epccs/Gravimetric/Applications/DayNight/README.md

# Day-Night State Machine

## Overview

The manager has a day-night state machine that tracks voltage on the ALT_V power input (photovoltaic) to tell if it is day or night. The 324pb application controler can access the state machine over I2C.

Note: use the Day_AttachDayWork() and Night_AttachWork() functions to register a callback that will be run at the start of each day. This framework is how I debugged the day-night stat machine.

## Wiring Needed for Light Sensor

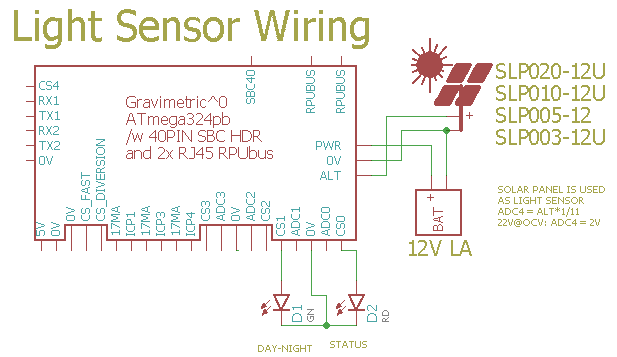
[picture p15: Applications/DayNight/Setup/LightSensorWiring.png]
Wiring


The ALT input has a [voltage divider] that is used to sense input voltage (solar pannel or a current source).

[voltage divider]: https://en.wikipedia.org/wiki/Voltage_divider

# Firmware Upload

The manager needs to be told that it has a localhost and the address to bootload. I do this with some commands on the SMBus interface from an R-Pi.

``` 
sudo apt-get install i2c-tools python3-smbus
sudo usermod -a -G i2c your_user_name
# logout for the change to take
python3
import smbus
bus = smbus.SMBus(1)
#write_i2c_block_data(I2C_ADDR, I2C_COMMAND, DATA)
#read_i2c_block_data(I2C_ADDR, I2C_COMMAND, NUM_OF_BYTES)
# what is my address
bus.write_i2c_block_data(42, 0, [255])
print("'"+chr(bus.read_i2c_block_data(42, 0, 2)[1])+"'" )
'2'
# I want to bootload address '1'
bus.write_i2c_block_data(42, 3, [ord('1')])
print("'"+chr(bus.read_i2c_block_data(42, 3, 2)[1])+"'" )
'1'
# clear the host lockout status bit so nRTS from my R-Pi on '2' will triger the bootloader on '1'
bus.write_i2c_block_data(42, 7, [0])
print(bus.read_i2c_block_data(42,7, 2))
[7, 0]
exit()
```

Or use the bootload port.

Now the serial port connection (see BOOTLOAD_PORT in Makefile) can reset the MCU and execute optiboot so that the 'make bootload' rule can upload a new binary image in the application area of flash memory.

``` 
sudo apt-get install make git picocom gcc-avr binutils-avr gdb-avr avr-libc avrdude
git clone https://github.com/epccs/Gravimetric/
cd /Gravimetric/Applications/DayNight
make
make bootload
...
avrdude done.  Thank you.
``` 

Now connect with picocom (or ilk).

``` 
#exit is C-a, C-x
picocom -b 38400 /dev/ttyAMA0
# with bootload port
picocom -b 38400 /dev/ttyUSB0
``` 

# Commands

Commands are interactive over the serial interface at 38400 baud rate. The echo will start after the second character of a new line. 

## /\[rpu_address\]/\[command \[arg\]\]

rpu_address is taken from the manager at I2C address 0x29 (e.g. ../Uart/id.h get_Rpu_address() ). The value of rpu_address is used as a character in a command string, which means don't use a null value (C strings are null terminated), but the ASCII value for '1' (0x31) is easy and looks nice.

The STATUS_LED is bliked fast (twice per second) if the I2C address is not found, also the rpu_address defaults to '0'. 

Commands and their arguments follow.

## /0/id? \[name|desc|avr-gcc\]

Identify is from ../Uart/id.h Id().

``` 
/1/id?
{"id":{"name":"DayNight","desc":"Gravimetric (17341^1) Board /w ATmega324pb","avr-gcc":"5.4.0"}}
```

## /0/dnmdebounc? [value]

Set manager daynight state machine daynight_morning_debounce.

```
/1/dnmdebounc?
{"mor_debounce":"1200000"}
/1/dnmdebounc? 18000
{"mor_debounce":"18000"}
/1/dnmdebounc?
{"mor_debounce":"18000"}
```

## /0/dnedebounc? [value]

Set manager daynight state machine daynight_evening_debounce.

```
/1/dnedebounc?
{"eve_debounce":"1200000"}
/1/dnedebounc? 18000
{"eve_debounce":"18000"}
/1/dnedebounc?
{"eve_debounce":"18000"}
```

## /0/dnmthresh? [value]

Set daynight state machine daynight_morning_threshold

```
/1/dnmthresh?
{"mor_threshold":"80"}
```

## /0/dnethresh? [value]

Set daynight state machine daynight_evening_threshold

```
/1/dnethresh?
{"eve_threshold":"40"}
```

## /0/day?

Report status of the state machine.

``` 
/1/day?
{"state":"0x0","mor_threshold":"80","eve_threshold":"40","adc_alt_v":"0","mor_debounce":"18000","eve_debounce":"18000","dn_timer":"21638728"}
{"state":"0x0","mor_threshold":"80","eve_threshold":"40","adc_alt_v":"0","mor_debounce":"18000","eve_debounce":"18000","dn_timer":"21643726"}
{"state":"0x0","mor_threshold":"80","eve_threshold":"40","adc_alt_v":"0","mor_debounce":"18000","eve_debounce":"18000","dn_timer":"21648726"}
{"state":"0x0","mor_threshold":"80","eve_threshold":"40","adc_alt_v":"0","mor_debounce":"18000","eve_debounce":"18000","dn_timer":"21653726"}
{"state":"0x0","mor_threshold":"80","eve_threshold":"40","adc_alt_v":"0","mor_debounce":"18000","eve_debounce":"18000","dn_timer":"21658725"}
{"state":"0x0","mor_threshold":"80","eve_threshold":"40","adc_alt_v":"0","mor_debounce":"18000","eve_debounce":"18000","dn_timer":"21663725"}
{"state":"0x5","mor_threshold":"80","eve_threshold":"40","adc_alt_v":"239","mor_debounce":"18000","eve_debounce":"18000","dn_timer":"2885"}
{"state":"0x5","mor_threshold":"80","eve_threshold":"40","adc_alt_v":"239","mor_debounce":"18000","eve_debounce":"18000","dn_timer":"7885"}
{"state":"0x5","mor_threshold":"80","eve_threshold":"40","adc_alt_v":"239","mor_debounce":"18000","eve_debounce":"18000","dn_timer":"12885"}
{"state":"0x5","mor_threshold":"80","eve_threshold":"40","adc_alt_v":"239","mor_debounce":"18000","eve_debounce":"18000","dn_timer":"17885"}
Day: Charge the battry
        WaterTheGarden
{"state":"0x1","mor_threshold":"80","eve_threshold":"40","adc_alt_v":"239","mor_debounce":"18000","eve_debounce":"18000","dn_timer":"4884"}
{"state":"0x1","mor_threshold":"80","eve_threshold":"40","adc_alt_v":"239","mor_debounce":"18000","eve_debounce":"18000","dn_timer":"9884"}
{"state":"0x1","mor_threshold":"80","eve_threshold":"40","adc_alt_v":"238","mor_debounce":"18000","eve_debounce":"18000","dn_timer":"14884"}
{"state":"0x2","mor_threshold":"80","eve_threshold":"40","adc_alt_v":"0","mor_debounce":"18000",Night: Block PV caused night current loss
          TurnOnLED's
"eve_debounce":"18000","dn_timer":"30"}
{"state":"0x4","mor_threshold":"80","eve_threshold":"40","adc_alt_v":"0","mor_debounce":"18000","eve_debounce":"18000","dn_timer":"5014"}
{"state":"0x4","mor_threshold":"80","eve_threshold":"40","adc_alt_v":"0","mor_debounce":"18000","eve_debounce":"18000","dn_timer":"10014"}
{"state":"0x4","mor_threshold":"80","eve_threshold":"40","adc_alt_v":"0","mor_debounce":"18000","eve_debounce":"18000","dn_timer":"15014"}
```

The state is unknown until the application receives an event update.
