epccs/Gravimetric/Manager/manager/PointToPoint.md

# Point To Point and Management Commands

16..31 (Ox10..0x1F | 0b00010000..0b00011111)

16. set arduino_mode (uint8_t)
17. read arduino_mode (uint8_t)
18. Access battery_low_limit (uint16_t)
19. Access battery_high_limit (uint16_t)
20. Battery absorption (e.g., alt_pwm_accum_charge_time) time (uint32_t)
21. morning_threshold (uint16_t). Day starts when ALT_V is above morning_threshold for morning_debouce time.
22. evening_threshold (uint16_t). Night starts when ALT_V is bellow evening_threshold for evening_debouce time.
23. Day-Night state (4 x uint8_t).

Note: morning_debouce and evening_debouce are part of the Day-Night state machine but there I2C commands are found in the test section (for now).

## Cmd 16 from a controller /w i2c-debug set p2p mode

set arduino_mode so LOCKOUT_DELAY and BOOTLOADER_ACTIVE last forever when the host RTS toggles active. Arduino IDE can then make p2p connections to the bootload address.

``` 
picocom -b 38400 /dev/ttyUSB0
/1/iaddr 41
{"address":"0x29"}
/1/ibuff 16,1
{"txBuffer[2]":[{"data":"0x10"},{"data":"0x01"}]}
/1/iread? 2
{"rxBuffer":[{"data":"0x10"},{"data":"0x01"}]}
``` 

That was silly since i2c-debug will read the RPUbus address over I2C and cause the manager to send a normal mode (e.g., point to multi-point) on the DTR pair. 

## Cmd 16 from a Raspberry Pi set p2p mode

An R-Pi host can do it with SMBus, lets try with two RPUpi boards.

``` 
python3
import smbus
bus = smbus.SMBus(1)
#write_i2c_block_data(I2C_ADDR, I2C_COMMAND, DATA)
#read_i2c_block_data(I2C_ADDR, I2C_COMMAND, NUM_OF_BYTES)
# what is the bootload address
bus.write_i2c_block_data(42, 2, [255])
bus.read_i2c_block_data(42, 2, 2)
[2, 48]
# what is my address
bus.write_i2c_block_data(42, 0, [255])
bus.read_i2c_block_data(42, 0, 2)
[0, 50]
# set the bootload address to my address
bus.write_i2c_block_data(42, 3, [ord('2')])
bus.read_i2c_block_data(42, 3, 2)
[3, 50]
# clear the host lockout status bit so serial from this host can work
bus.write_i2c_block_data(42, 7, [0])
print(bus.read_i2c_block_data(42, 7, 2))
[7, 0]
exit()
# on an RPUno load the blinkLED application which does not read the bus address
git clone https://github.com/epccs/RPUno
cd /RPUno/BlinkLED
make
make bootload
# now back to 
python3
import smbus
bus = smbus.SMBus(1)
# and set the arduino_mode
bus.write_i2c_block_data(42, 16, [1])
print(bus.read_i2c_block_data(42, 16, 2))
[16, 1]
# the R-Pi host can now connect by serial so LOCKOUT_DELAY and BOOTLOADER_ACTIVE last forever
``` 

Now the R-Pi can connect to serial in P2P mode.

``` 
picocom -b 38400 /dev/ttyAMA0
``` 

At this time, the point to point mode persists, I will sort out more details when they are needed.

## Cmd 17 from a Raspberry Pi read p2p mode

An R-Pi host can use SMBus to check for p2p mode.

```
python3
import smbus
bus = smbus.SMBus(1)
#write_i2c_block_data(I2C_ADDR, I2C_COMMAND, DATA)
#read_i2c_block_data(I2C_ADDR, I2C_COMMAND, NUM_OF_BYTES)
# is it in p2p mode (a zero shows that the running app has read the rpubus address)
bus.write_i2c_block_data(42, 17, [255])
print(bus.read_i2c_block_data(42, 17, 2))
[65, 0]
```

## Cmd 18 from a controller /w i2c-debug to access battery_low_limit

Send an ignored integer (0) in two bytes to see what the battery_low_limit value is.

``` 
# I am using the bootload interface 
picocom -b 38400 /dev/ttyUSB0
/1/iaddr 41
{"address":"0x29"}
/1/ibuff 18,0,0
{"txBuffer[3]":[{"data":"0x12"},{"data":"0x0"},{"data":"0x0"}]}
/1/iread? 3
{"rxBuffer":[{"data":"0x12"},{"data":"0x1"},{"data":"0x76"}]}
```

The settings are in battery_limits.h. The power_manager.c routines use the value to start charging, and when analogRead(PWR_V) is halfway between battery_low_limit and battery_high_limit to start modulating (PWM) the charge. To convert the value to the corrected voltage see command 35 ( (( (2**8)*0x1 + 0x76)/1024)*5.0*((100+15.8)/15.8) = 13.38V).

``` 
/1/ibuff 18,1,119
{"txBuffer[3]":[{"data":"0x12"},{"data":"0x1"},{"data":"0x77"}]}
/1/iread? 3
{"rxBuffer":[{"data":"0x12"},{"data":"0x1"},{"data":"0x76"}]}
/1/ibuff 18,0,0
{"txBuffer[3]":[{"data":"0x12"},{"data":"0x0"},{"data":"0x0"}]}
/1/iread? 3
{"rxBuffer":[{"data":"0x12"},{"data":"0x1"},{"data":"0x77"}]}
```

The data sent was swapped with the default; the second exchange has ignored data so we can see the updated value did change.

## Cmd 19 from a controller /w i2c-debug to access battery_high_limit

Send an ignored integer (0) in two bytes to see what the battery_high_limit value is.

``` 
# I am using the bootload interface 
picocom -b 38400 /dev/ttyUSB0
/1/iaddr 41
{"address":"0x29"}
/1/ibuff 19,0,0
{"txBuffer[3]":[{"data":"0x13"},{"data":"0x0"},{"data":"0x0"}]}
/1/iread? 3
{"rxBuffer":[{"data":"0x13"},{"data":"0x1"},{"data":"0x8D"}]}
```

The settings are in battery_limits.h. The power_manager.c routines use the value to stop charging, and when analogRead(PWR_V) is halfway between battery_low_limit and battery_high_limit to start modulating (PWM) the charge. To convert the value to the corrected voltage see command 35 ( (( (2**8)*0x1 + 0x8D)/1024)*5.0*((100+15.8)/15.8) = 14.21V).

``` 
/1/ibuff 19,1,142
{"txBuffer[3]":[{"data":"0x13"},{"data":"0x1"},{"data":"0x8E"}]}
/1/iread? 3
{"rxBuffer":[{"data":"0x13"},{"data":"0x1"},{"data":"0x8D"}]}
/1/ibuff 19,0,0
{"txBuffer[3]":[{"data":"0x13"},{"data":"0x0"},{"data":"0x0"}]}
/1/iread? 3
{"rxBuffer":[{"data":"0x13"},{"data":"0x1"},{"data":"0x8E"}]}
```

The data sent was swapped with the default; the second exchange has ignored data so we can see the updated value did change.

## Cmd 20 from the application controller /w i2c-debug running read alt_pwm_accum_charge_time.

Battery absorption occures durring alt_pwm_accum_charge_time, it accumulates the millis time while alternat power was used to charge the battery not the off time. Read four bytes from I2C. They are bytes to a UINT32 from a buffered accumulation of millis reading.

``` 
picocom -b 38400 /dev/ttyUSB0
/1/iaddr 41
{"address":"0x29"}
/1/ibuff 20,0,0,0,0
{"txBuffer[5]":[{"data":"0x14"},{"data":"0x0"},{"data":"0x0"},{"data":"0x0"},{"data":"0x0"}]}
/1/iread? 5
{"rxBuffer":[{"data":"0x14"},{"data":"0x0"},{"data":"0x0"},{"data":"0x0"},{"data":"0x0"}]}
``` 

This needs checked with a battery.

## Cmd 21 from a controller /w i2c-debug to access morning_threshold

Send an ignored integer (0) in two bytes to see what the morning_threshold value is.

``` 
# I am using the bootload interface 
picocom -b 38400 /dev/ttyUSB0
/1/iaddr 41
{"address":"0x29"}
/1/ibuff 21,0,0
{"txBuffer[3]":[{"data":"0x15"},{"data":"0x0"},{"data":"0x0"}]}
/1/iread? 3
{"rxBuffer":[{"data":"0x15"},{"data":"0x0"},{"data":"0x50"}]}
```

There are two ranges (12V and 24V) for solar panels; data that is outside the valid area is ignored. The settings are in daynight_limits.h. 

``` 
/1/ibuff 21,0,81
{"txBuffer[3]":[{"data":"0x15"},{"data":"0x0"},{"data":"0x51"}]}
/1/iread? 3
{"rxBuffer":[{"data":"0x15"},{"data":"0x0"},{"data":"0x50"}]}
/1/ibuff 21,0,0
{"txBuffer[3]":[{"data":"0x15"},{"data":"0x0"},{"data":"0x0"}]}
/1/iread? 3
{"rxBuffer":[{"data":"0x15"},{"data":"0x0"},{"data":"0x51"}]}
```

The data sent was swapped with the default (80); the second exchange has ignored data that is swapped with the updated value (81).

## Cmd 22 from a controller /w i2c-debug to access evening_threshold

Send an ignored integer (0) in two bytes to see what the evening_threshold value is.

``` 
# I am using the bootload interface 
picocom -b 38400 /dev/ttyUSB0
/1/iaddr 41
{"address":"0x29"}
/1/ibuff 22,0,0
{"txBuffer[3]":[{"data":"0x16"},{"data":"0x0"},{"data":"0x0"}]}
/1/iread? 3
{"rxBuffer":[{"data":"0x16"},{"data":"0x0"},{"data":"0x28"}]}
```

There are two ranges (12V and 24V) for solar panels; data that is outside the valid area is ignored. The settings are in daynight_limits.h. 

``` 
/1/ibuff 22,0,37
{"txBuffer[3]":[{"data":"0x16"},{"data":"0x0"},{"data":"0x25"}]}
/1/iread? 3
{"rxBuffer":[{"data":"0x16"},{"data":"0x0"},{"data":"0x28"}]}
/1/ibuff 22,0,0
{"txBuffer[3]":[{"data":"0x16"},{"data":"0x0"},{"data":"0x0"}]}
/1/iread? 3
{"rxBuffer":[{"data":"0x16"},{"data":"0x0"},{"data":"0x25"}]}
```

The data sent was swapped with the default (40); the second exchange has ignored data that is swapped with the updated value (37).

## Cmd 23 from a controller /w i2c-debug to set Day-Night i2c callback (4 x uint8_t).

Send four bytes to enable i2c callback for events. Address, daynight_state events, day event, night event. 

Address (0x31) is the i2c slave address that will receive the events. The daynight_state event (0x1) is the command byte used when daynight_state changes. The day (0x2) and night (0x3) event command is called so user functions can run functions.  The i2c slave needs to be implemented for the callbacks to operate, the manager will keep trying to master the i2c bus, but quit after an address NAK. 

``` 
# I am using the bootload interface 
picocom -b 38400 /dev/ttyUSB0
/1/iaddr 41
{"address":"0x29"}
/1/ibuff 23,43,1,2,3
{"txBuffer[5]":[{"data":"0x17"},{"data":"0x31"},{"data":"0x1"},{"data":"0x2"},{"data":"0x3"}]}
/1/iread? 5

```

States are in the daynight_state.h file.

``` C
#define DAYNIGHT_START_STATE 0
#define DAYNIGHT_DAY_STATE 1
#define DAYNIGHT_EVENING_DEBOUNCE_STATE 2
#define DAYNIGHT_NIGHTWORK_STATE 3
#define DAYNIGHT_NIGHT_STATE 4
#define DAYNIGHT_MORNING_DEBOUNCE_STATE 5
#define DAYNIGHT_DAYWORK_STATE 6
#define DAYNIGHT_FAIL_STATE 7
```

It is night since ALT_V was 0V after startup, it will switch to 7 after 20 hours, but if not needed don't worry about it. 

Set bit 4 from master to clear bits 6 and 7

``` 
/1/ibuff 23,16
{"txBuffer[3]":[{"data":"0x17"},{"data":"0x10"}]}
/1/iread? 2
{"rxBuffer":[{"data":"0x17"},{"data":"0x4"}]}
```

Set bit 5 from master to include bits 6 and 7 in readback

```
/1/ibuff 23,32
{"txBuffer[3]":[{"data":"0x17"},{"data":"0x20"}]}
/1/iread? 2
{"rxBuffer":[{"data":"0x17"},{"data":"0x4"}]}
```

Bit 6 shows day_work. Bit 7 shows night_work. If set they need to be cleared after doing the work.
