epccs/Gravimetric/Hardware/Schooling/Gravimetric^0,Rework_R4.jpg

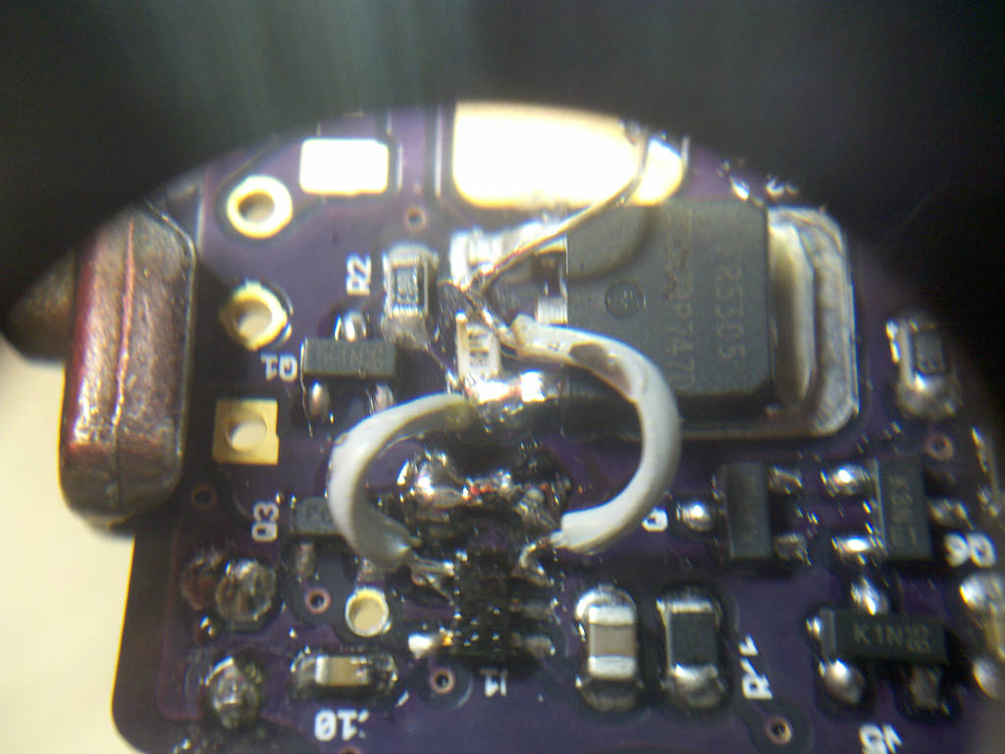
Hardware/Schooling/Gravimetric^0,Rework_R4.jpg
