epccs/Gravimetric/Hardware/Schooling/Gravimetric^1,R237_LayoutRef.png

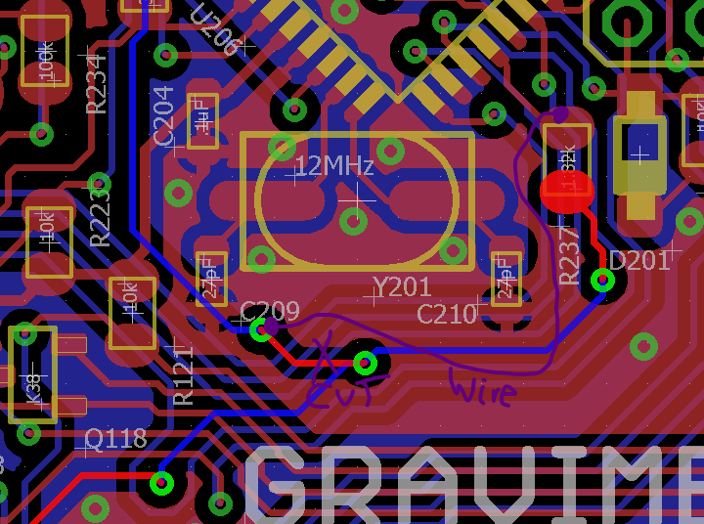
Hardware/Schooling/Gravimetric^1,R237_LayoutRef.png
