epccs/Gravimetric/Hardware/Design/17341BRD,BOM.csv

LINE | REF | QTY | EPCCS TYP | EPCCS PN | MFG@PN | DESCRIPTION | NOTES | COST EA | LINE COST | BIN
 |  |  |  |  |  | Gravimetric Board |  |  | TOTAL
 |  |  |  |  |  | 3/22/19 (17341^2) |  |  | =SUM(J5:J100)
1 |  | =1/3 | BOARD | OSHPARK |  | PCB 2 LAYER ENIG 3 COPY | () | 62.00 | =C5*I5 | GRAVIMETRIC
 |  |  |  |  |  | NOTES
