epccs/Gravimetric/Applications/Time-WeightCal/Setup/compact-prover.jpg

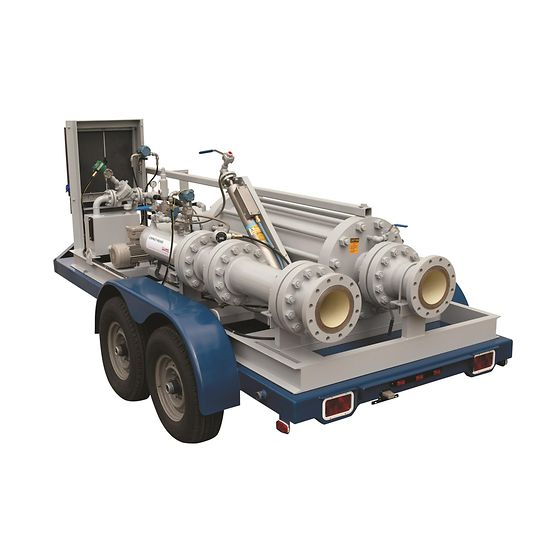
Applications/Time-WeightCal/Setup/compact-prover.jpg
