epccs/Gravimetric/Applications/Time-WeightCal/Setup/displacement_prover.jpg

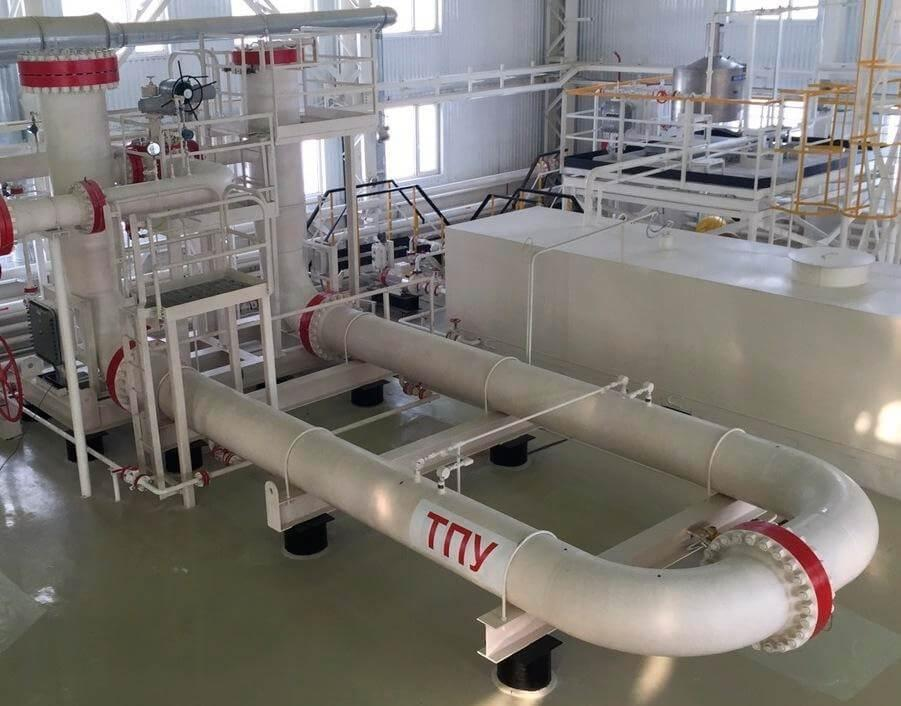
Applications/Time-WeightCal/Setup/displacement_prover.jpg
