epccs/Gravimetric/Applications/Time-WeightCal/Setup/master_meter_prover.jpg

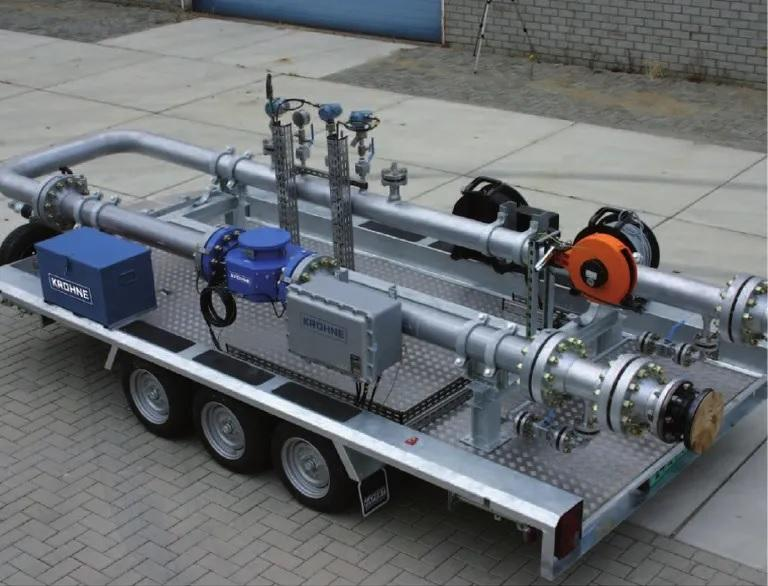
Applications/Time-WeightCal/Setup/master_meter_prover.jpg
