epccs/Gravimetric/(threads)

Thread 1 (2020-01-24):

Verify that the m32[48]pb Clock Fail Disable bit works.

epccs, 2020-01-24:
The default is 0. For a fuse, that means it is set, confusing? Yes! I have been setting it to 1 thinking... well enough about that.

My current hypothesis is that the chip will start in a failed mode (e.g., 8MHz internal) and then switch to the softly driven pendulum (low power crystal). However, once in that mode, if the crystal fails, it will be latched to the internal oscillator.

To test, I may be able to short the oscillator input pin to the ground at start-up and watch blink rate, then open the short, and see if it is faster, and short again to see if it slows and keeps going slow when open again.

epccs, 2020-01-24:
AN2365 Using CFD for ATmega328PB

http://ww1.microchip.com/downloads/en/Appnotes/AN2365-Using-CFD-for-ATmega328PB-DS00002365B.pdf

Thread 3 (2020-07-16):

I2C multi-boss bug

epccs, 2020-07-16:
Three Little Daemons

Actually, they are three state machines running. The day-night daemon (again it's a state machine) tracks the status of the alternate power input which could go to a solar panel. The battery-manager (bm) charges during the DAY and disconnects at other day-night states. The bm has some charging modes and trips the host shutdown if the battery is low. The host shutdown daemon enables the manual switch 90 seconds after powerup or after bringing the host UP from shutdown. When a shutdown occurs by software or manual switch the current is monitored to be stable for 90 seconds and then a 40-second delay occurs before removing power. The 90-second wait can be skipped if the application will stop alternating current usage (blinking LEDs) to cause current usage to be stable.

The daemons are done so that they can report state changes over I2C to the manager. This is done by changing the roles of the I2C devices, normally the application plays the role of boss, and sends things to the peon. But today the peon gets to become the new boss and send daemon events to the old demoted boss. Unfortunately, if the old boss tries to access things again the promoted peon can at times defecate on his ostentation (a bug I have not tied to fix, it seems appropriate for the times).
