epccs/Gravimetric/Hardware/Documents/17341,bAssy.pdf

5V IN | uUSB | HDMI

# uSD

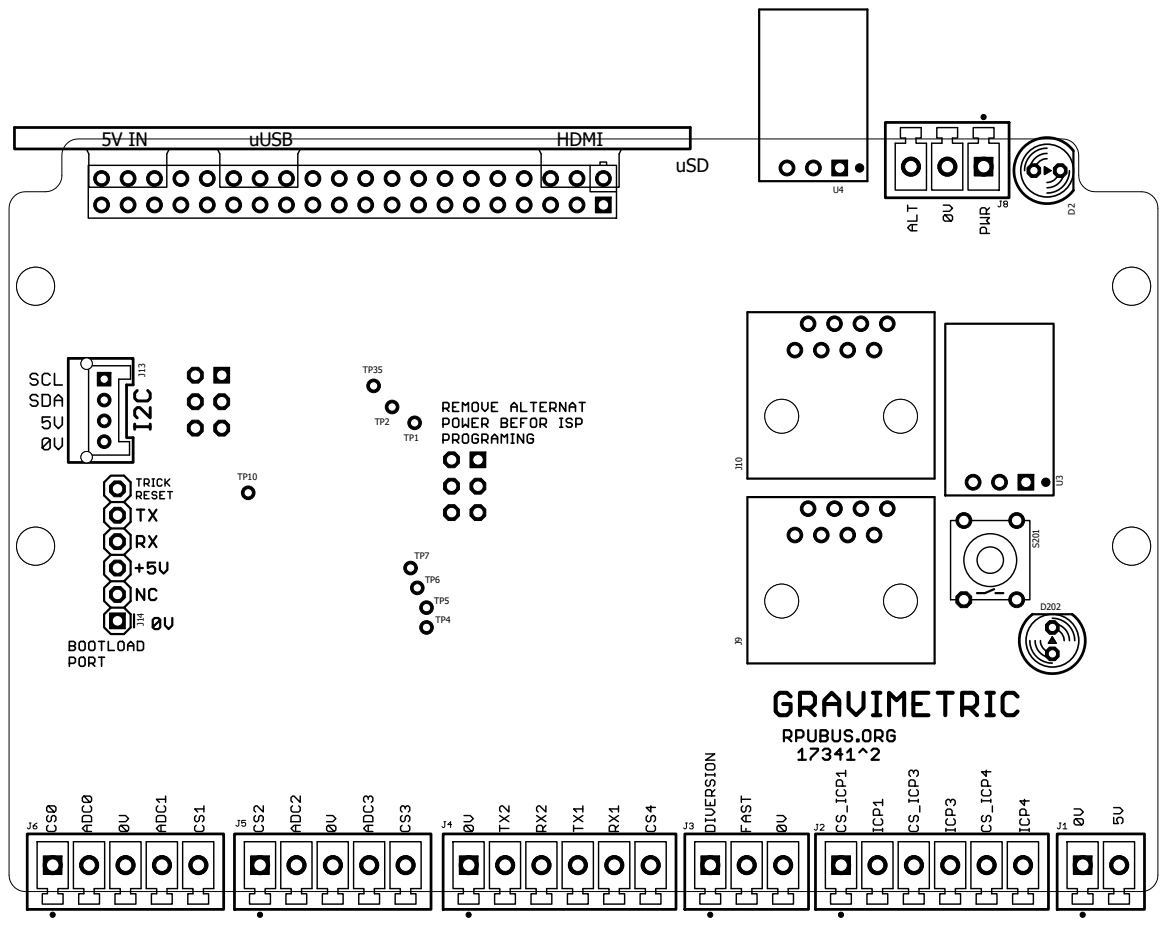
[picture p34: page 1]
