epccs/Gravimetric/Hardware/Documents/17341,Schematic.pdf

## POWER 7-36V

## BLOCKS -40V

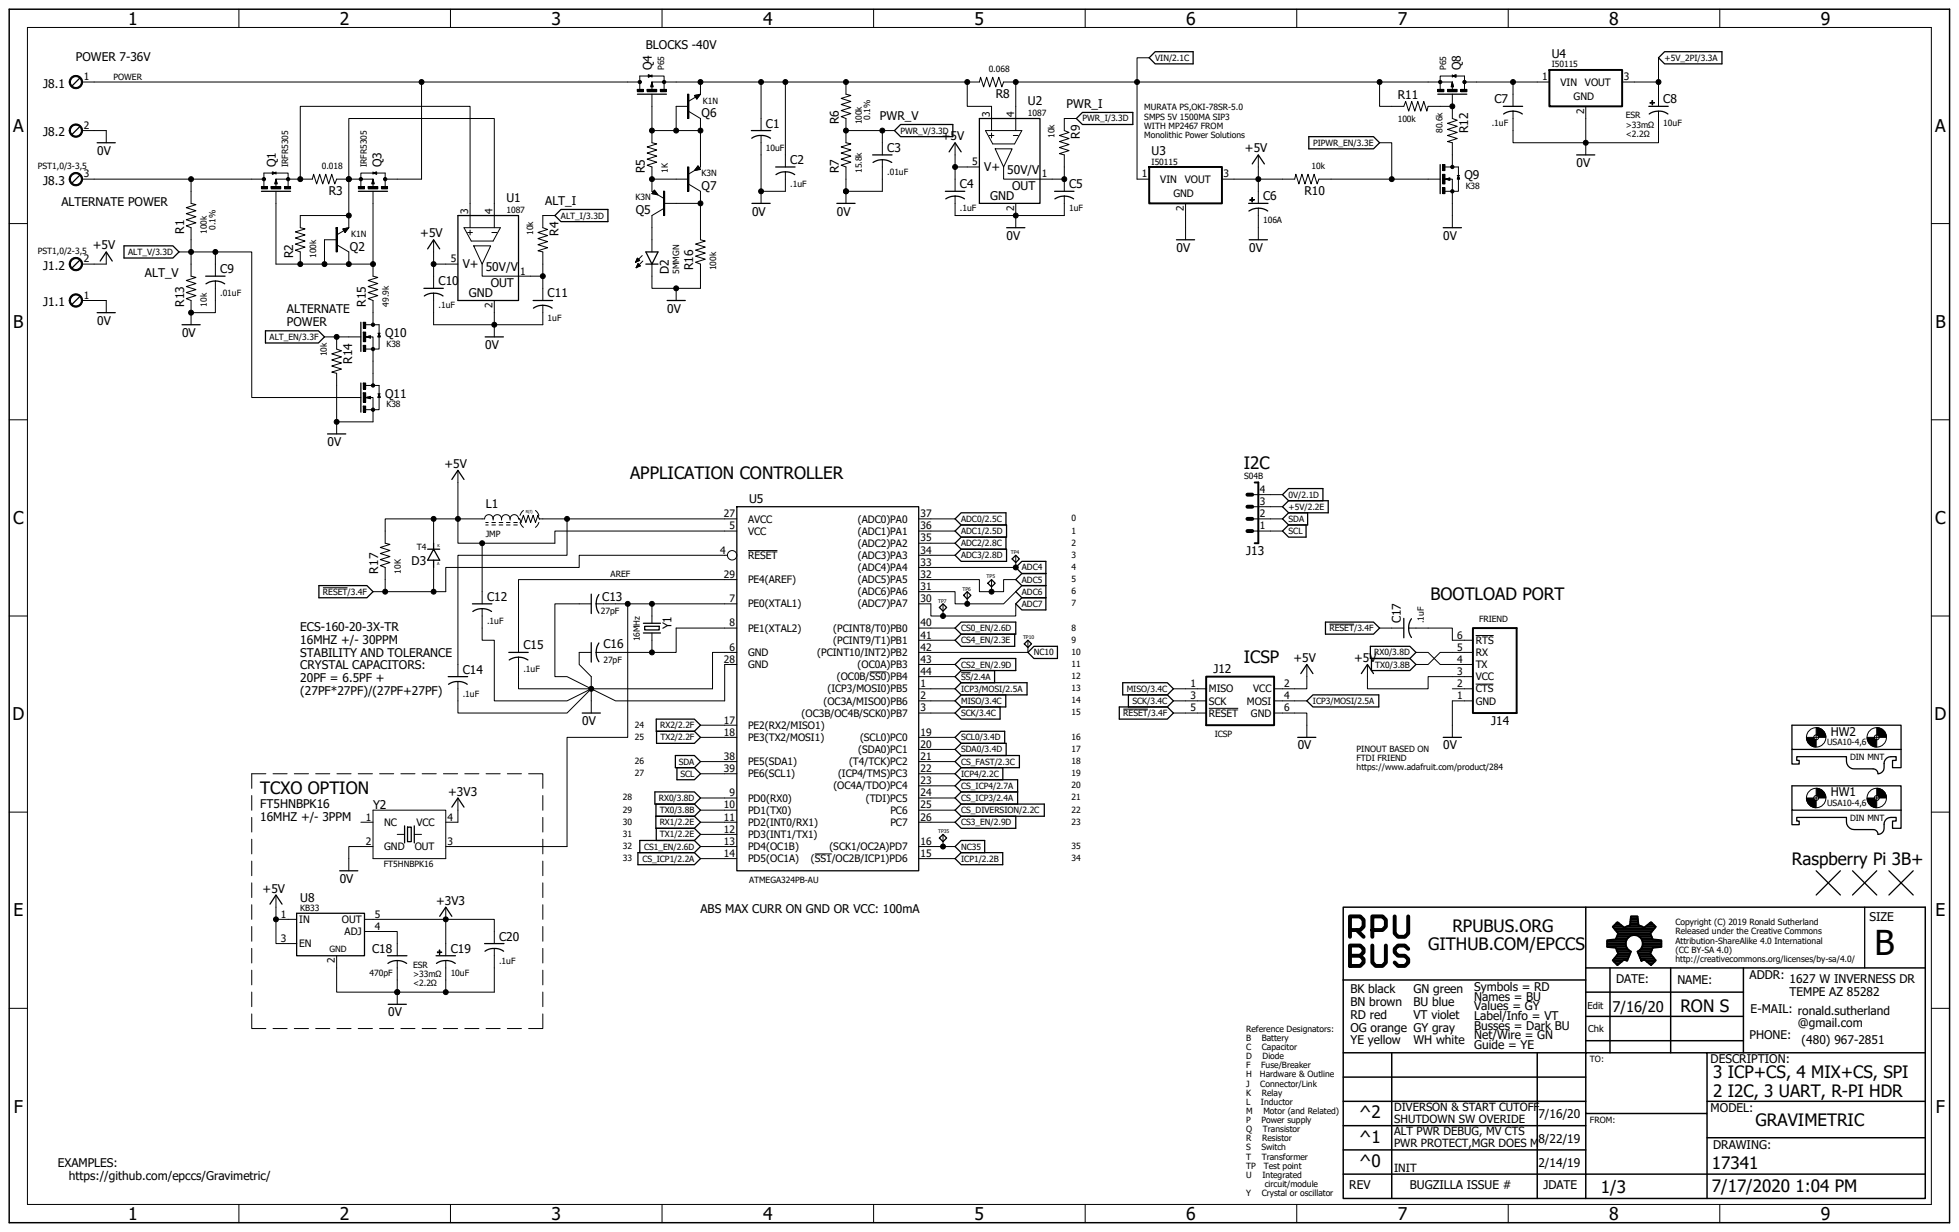
[picture p35: page 1]

PINOUT BASED ON
FTDI FRIEND
https://www.adafruit.com/product/284

ABS MAX CURR ON GND OR VCC: 100mA

Copyright (C) 2019 Ronald Sutherland
Released under the Creative Commons
Attribution-ShareAlike 4.0 International
http://creativecommons.org/licenses/by-sa/4.0/

Edit | 7/16/20 | RON S

Chk
TO: | DESCRIPTION: 3 ICP+CS, 4 MIX+CS, SPI 2 I2C, 3 UART, R-PI HDR

^2 | DIVERSON & START CUTOFF SHUTDOWN SW OVERIDE | 7/16/20 | | MODEL: GRAVIMETRIC
^1 | ALT PWR DEBUG, MV CTS PWR PROTECT,MGR DOES M8/22/19
^0 | | 2/14/19 INIT
REV | BUGZILLA ISSUE # | JDATE

EXAMPLES:
https://github.com/epccs/Gravimetric/

# PULSE SENSOR

## ICP3

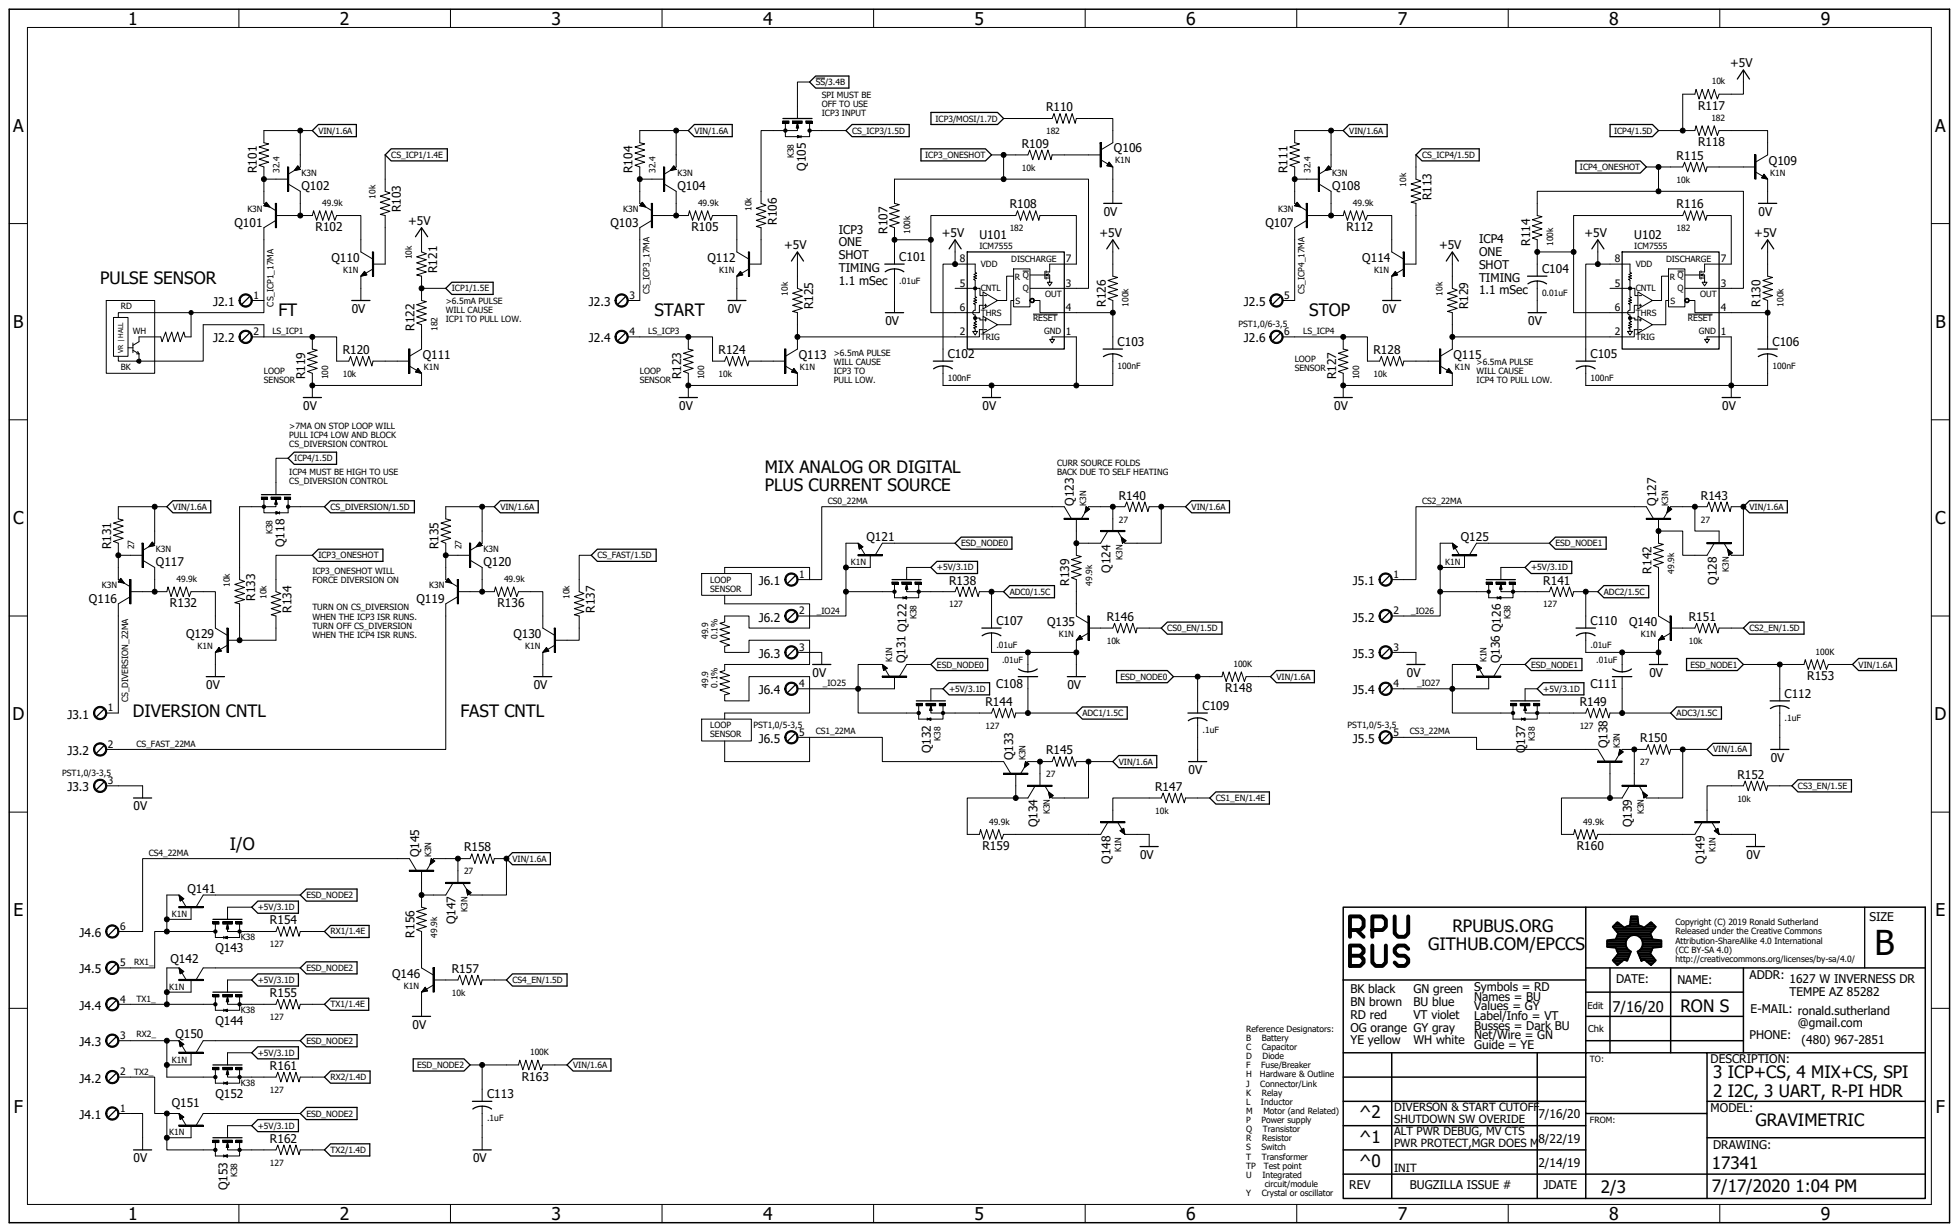
[picture p36: page 2]

>7MA ON STOP LOOP WILL
PULL ICP4 LOW AND BLOCK
CS_DIVERSION CONTROL
ICP4/1.5D
ICP4 MUST BE HIGH TO USE

MIX ANALOG OR DIGITAL
PLUS CURRENT SOURCE

CURR SOURCE FOLDS
BACK DUE TO SELF HEATING

TURN ON CS_DIVERSION
WHEN THE ICP3 ISR RUNS.
TURN OFF CS_DIVERSION
WHEN THE ICP4 ISR RUNS.

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

TO: | DESCRIPTION: 3 ICP+CS, 4 MIX+CS, SPI 2 I2C, 3 UART, R-PI HDR

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

# SMBus

# 40 PIN SBC (R-PI)

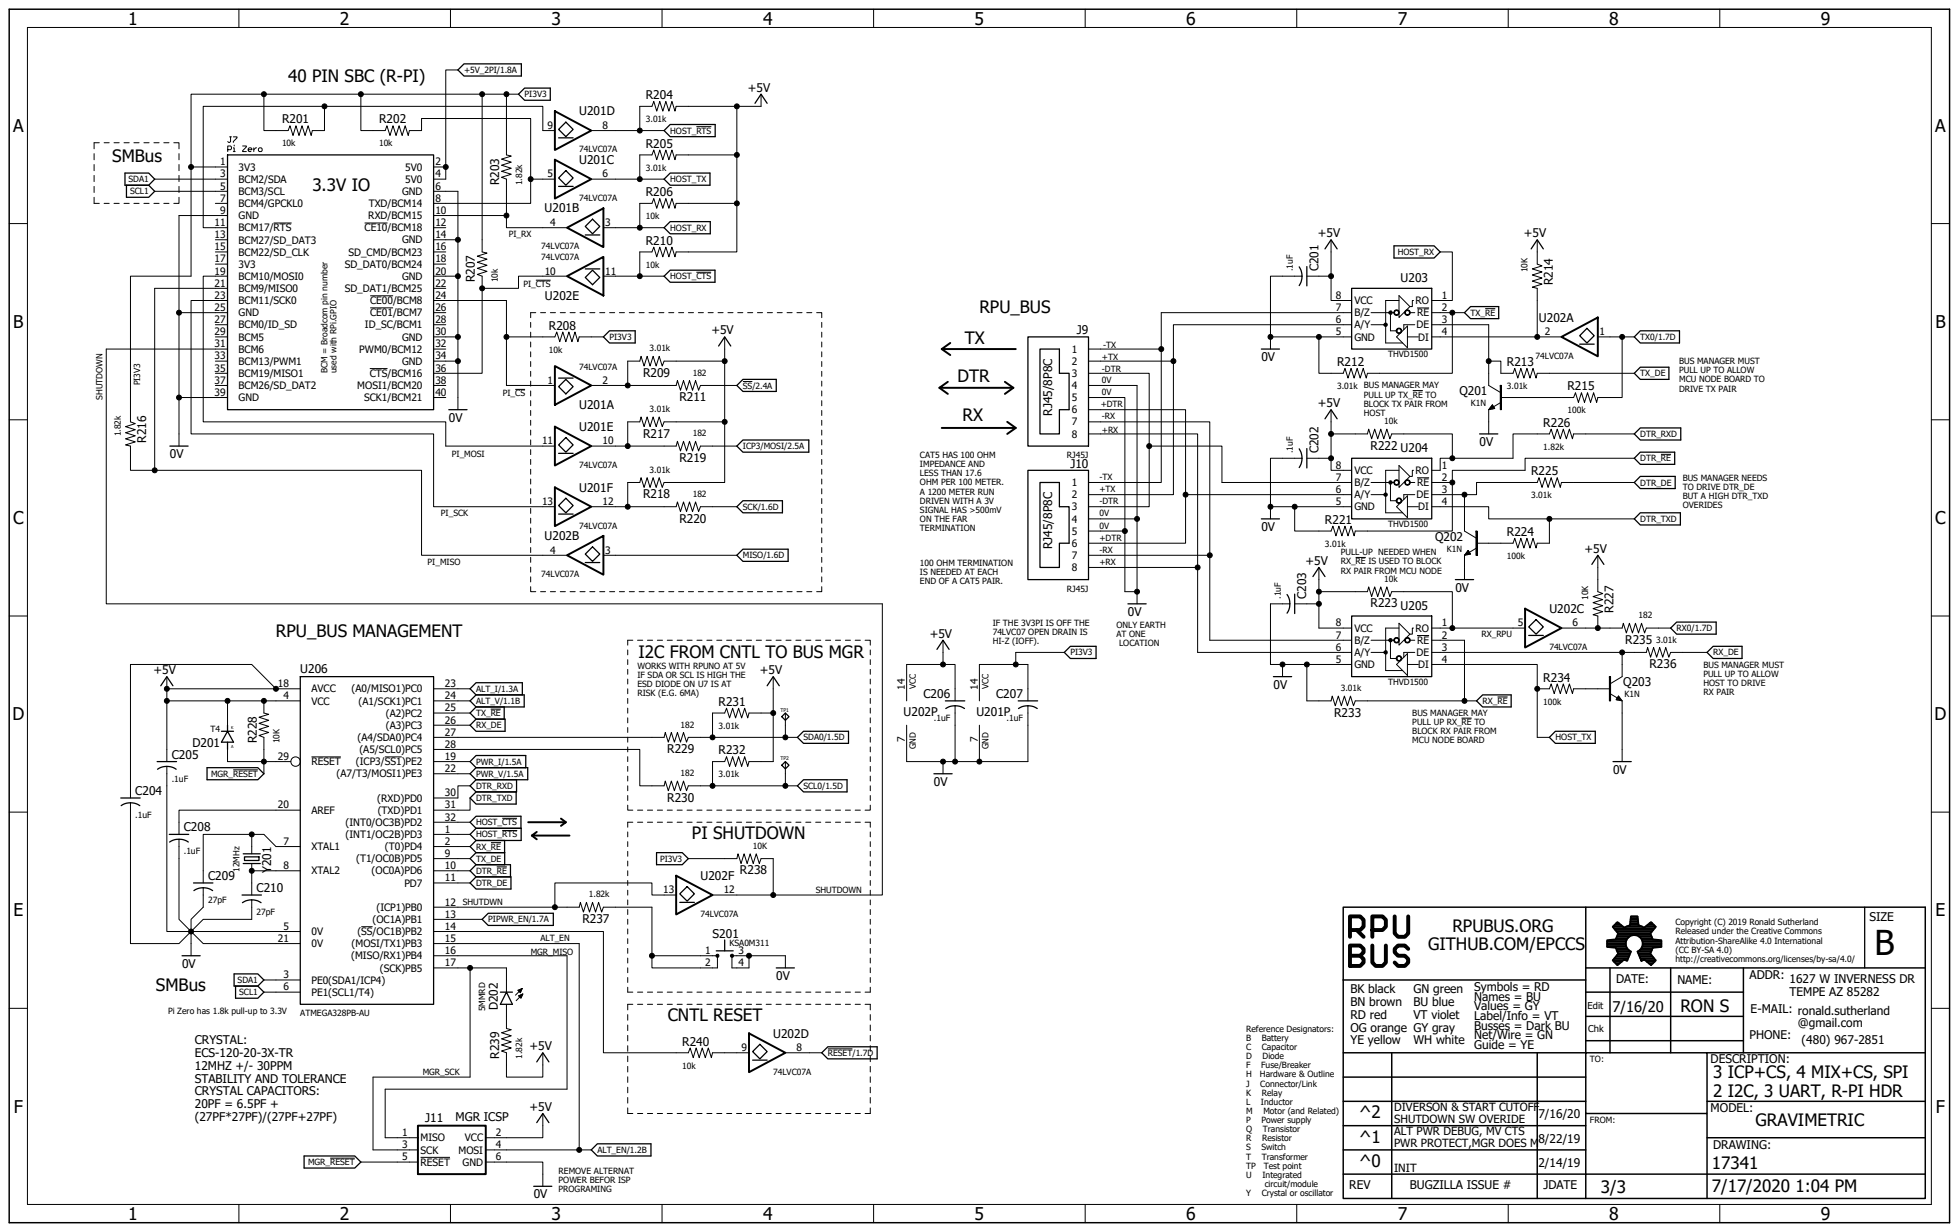
[picture p37: page 3]

BCM = Broadcom pin number

used with RPi.GPIO

BUS MANAGER MUST
PULL UP TO ALLOW
MCU NODE BOARD TO
DRIVE TX PAIR

100 OHM TERMINATION
IS NEEDED AT EACH
END OF A CAT5 PAIR.

RX_RE IS USED TO BLOCK
RX PAIR FROM MCU NODE

IF THE 3V3PI IS OFF THE
74LVC07 OPEN DRAIN IS
HI-Z (IOFF).

I2C FROM CNTL TO BUS MGR
WORKS WITH RPUNO AT 5V
IF SDA OR SCL IS HIGH THE
ESD DIODE ON U7 IS AT
RISK (E.G. 6MA)

HOST TO DRIVE
RX PAIR

BUS MANAGER MAY
PULL UP RX_RE TO
BLOCK RX PAIR FROM
MCU NODE BOARD

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

Edit | 7/16/20 | RON S

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
