epccs/Gravimetric/Hardware/Documents/17341,tAssy.pdf

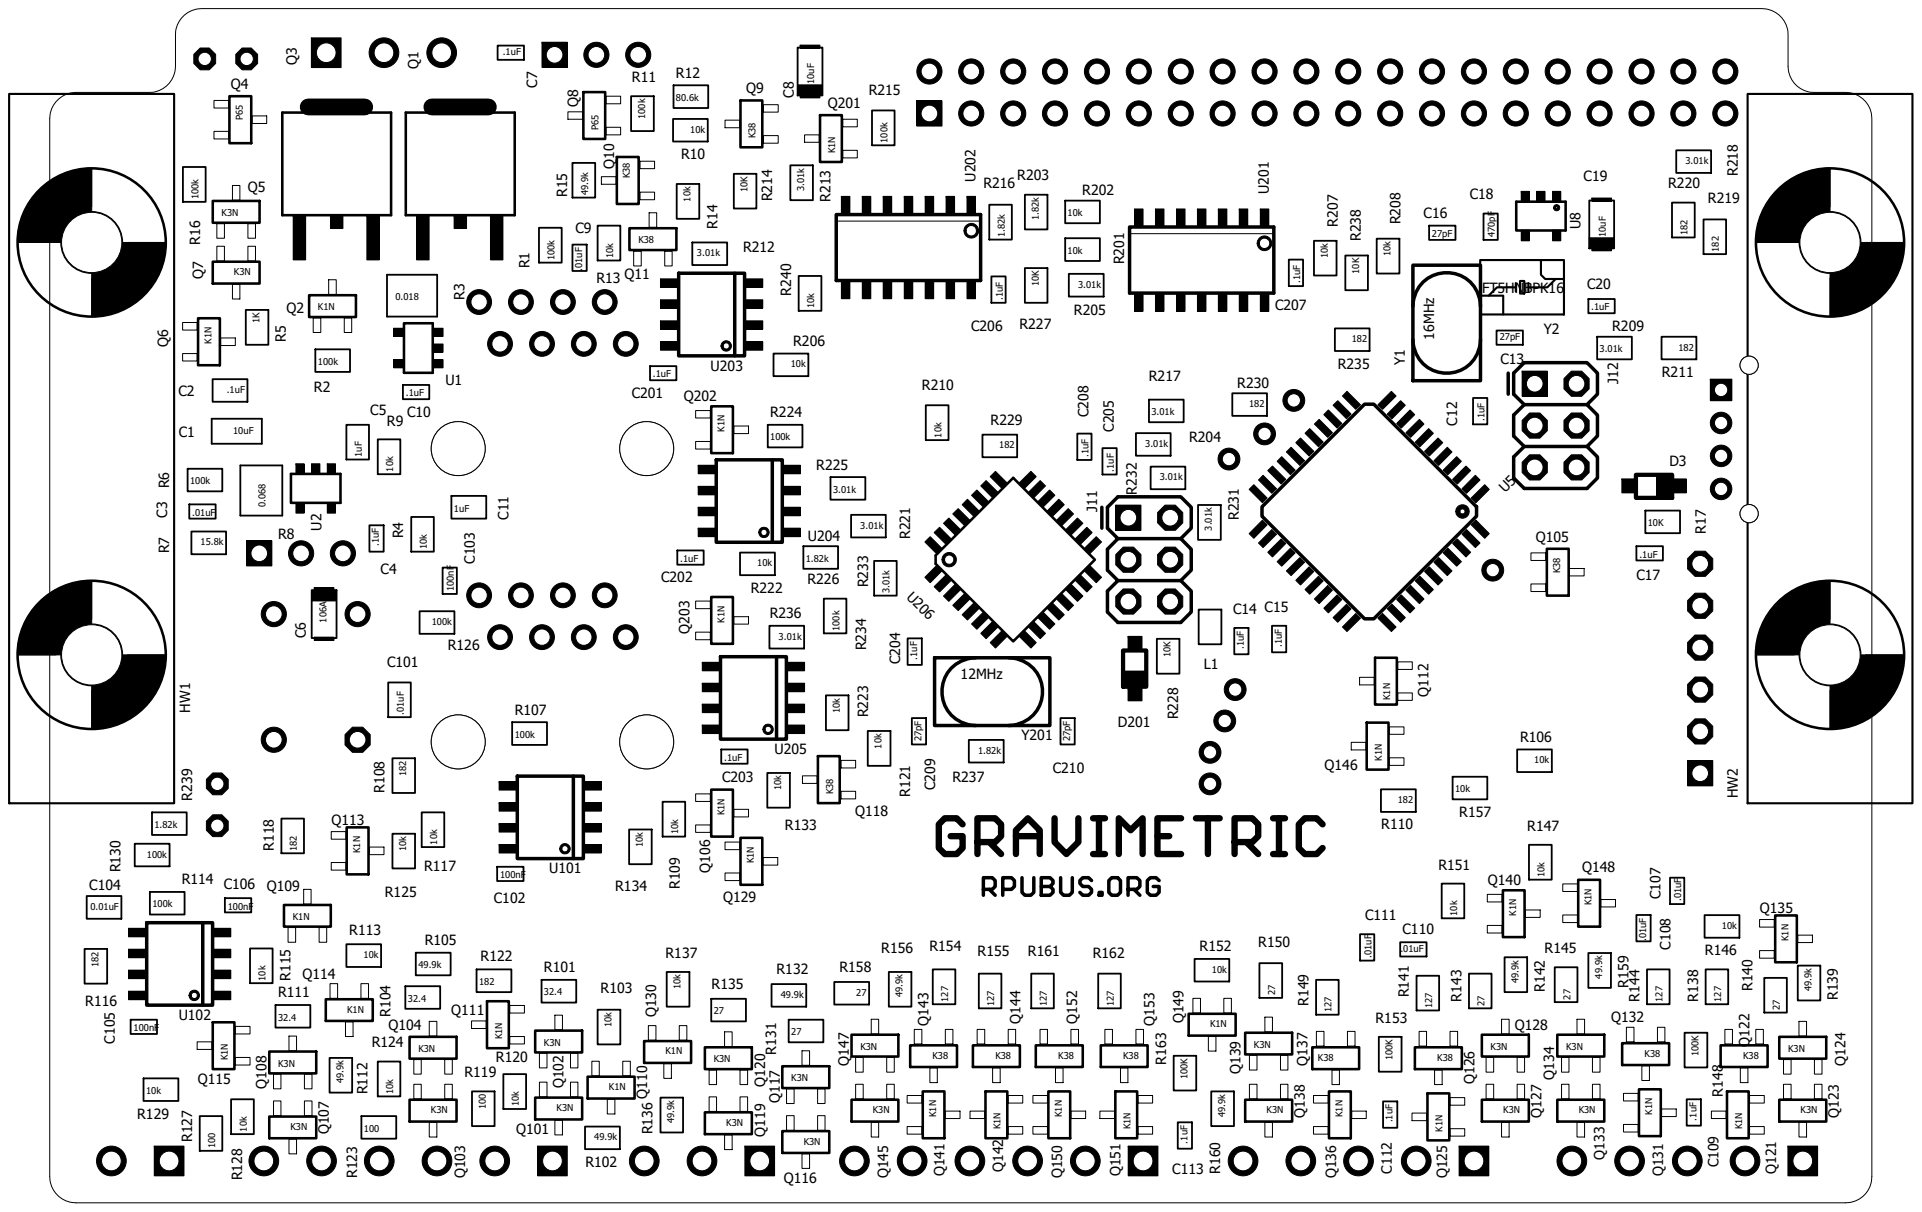
[picture p38: page 1]
