epccs/Gravimetric/Hardware/Design/MultiDrop.sch

## EAGLE design Hardware/Design/MultiDrop.sch (2019-02-22)

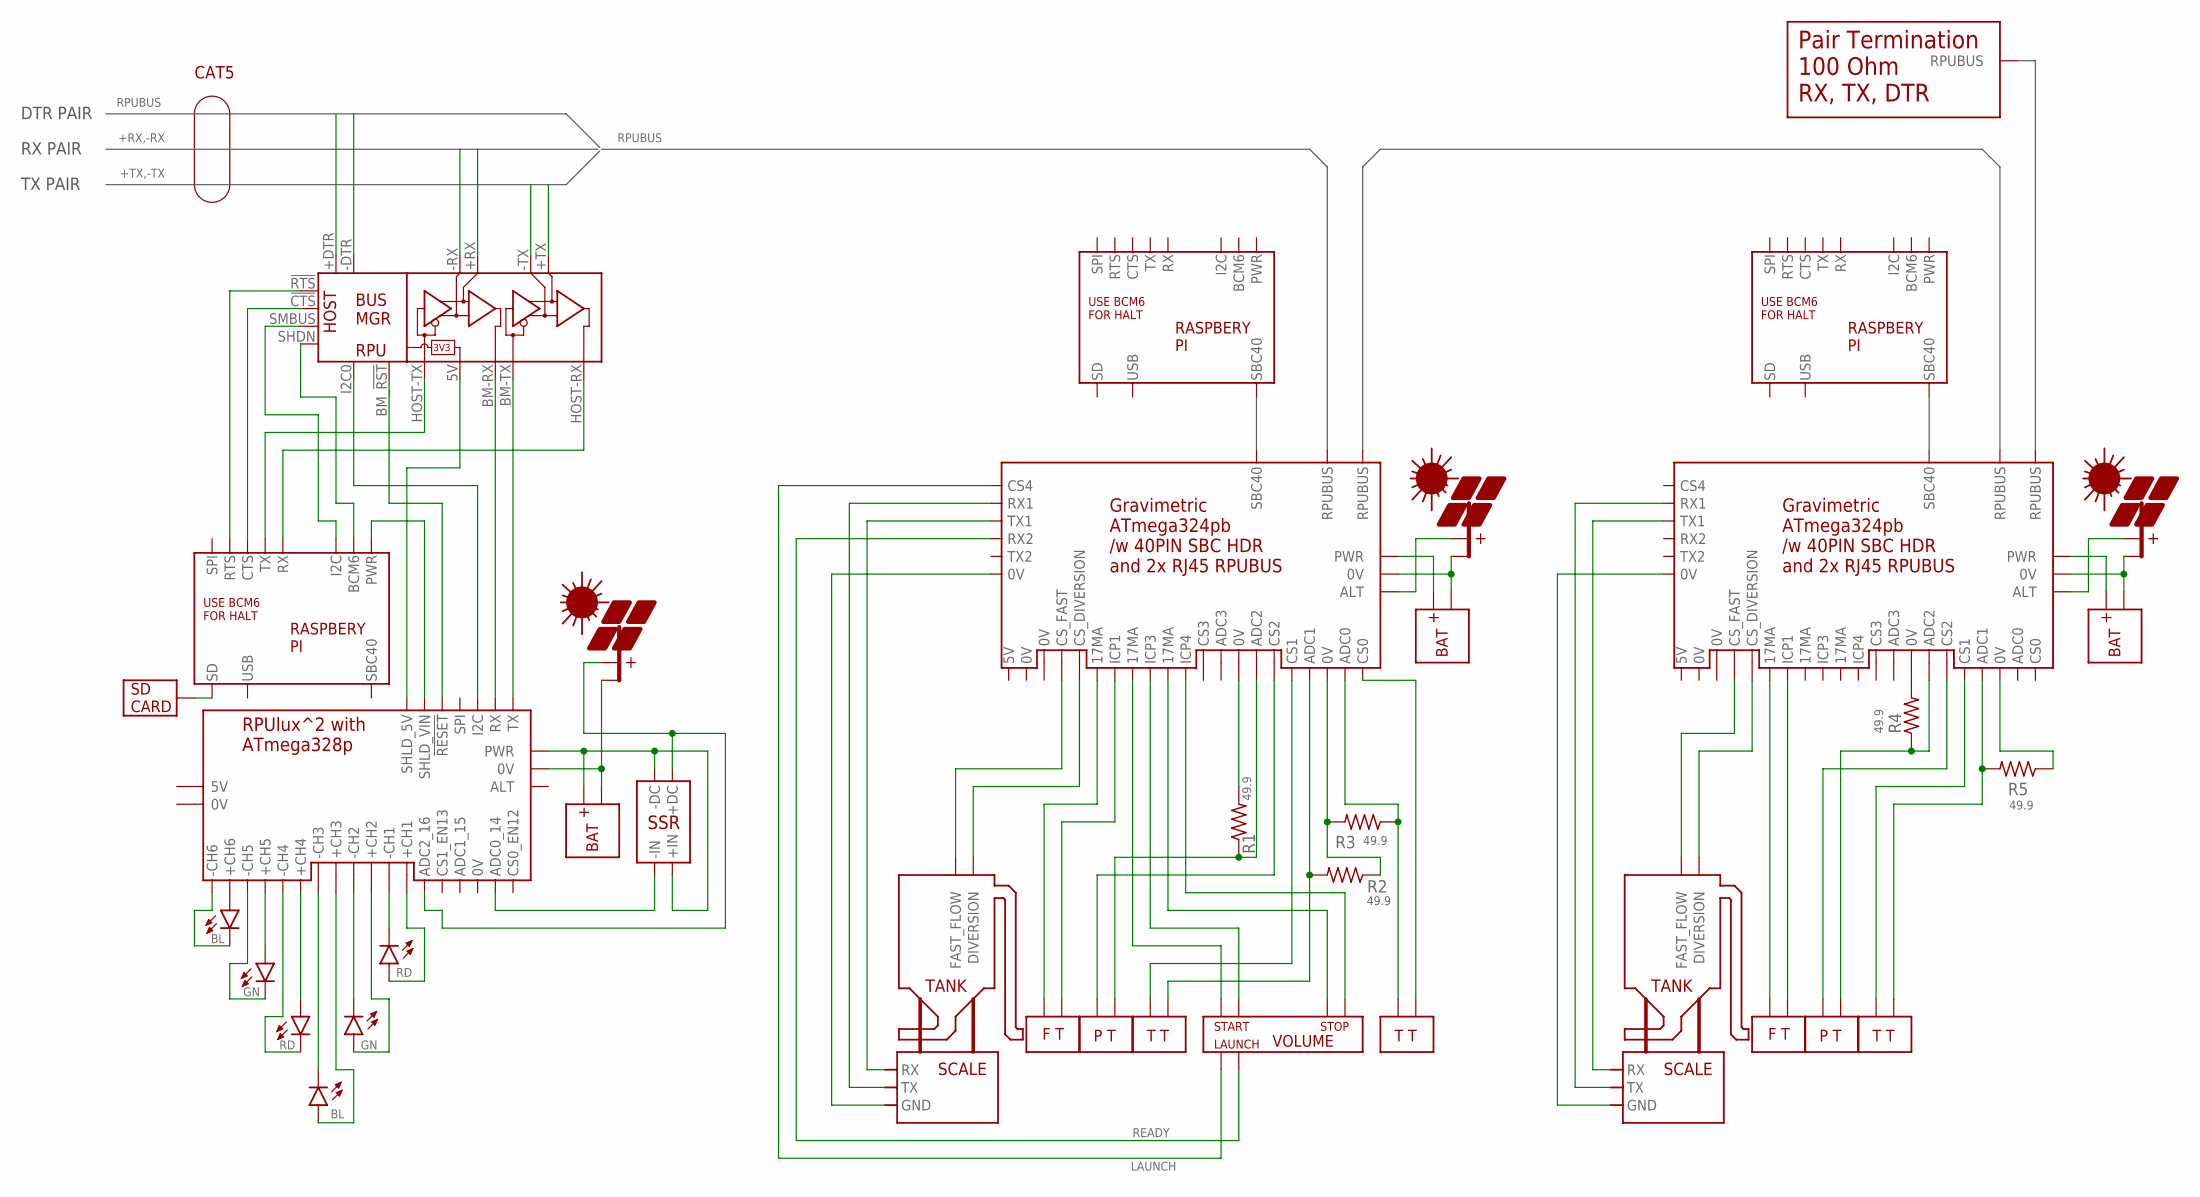
[picture p39: schematic MultiDrop.sch]

Parts:
BL1, BL2: BL; LED5MM
GN1, GN2: GN; LED5MM
PV1, PV2, PV4: PV; NA-30
R1, R2, R3, R4, R5: 49.9; C0805(2012)
RD1, RD2: RD; LED5MM
SD2: SD; NA-30
U$1, U$2: GRAVIMETRIC; WITH_RPU_NAMES
U$3, U$6, U$20: PI; NA-30
U$4: BUS_MGR; WITH_RPU_NAMES
U$5: TERM; NA-30
U$7, U$9, U$10: BAT; NA-30
U$8: SSR_DC; NA-30
U$11, U$16: FT; NA-30
U$12, U$17: PT; NA-30
U$13, U$14, U$18: TT; NA-30
U$15: VOLUME; NA-30
U$19: RPULUX; WITH_RPU_NAMES
U$21, U$22: SCALE; NA-30

Connections:
+DTR3: U$4.+DTR
+RX3: U$4.+RX
+TX3: U$4.+TX
-DTR3: U$4.-DTR
-RX3: U$4.-RX
-TX3: U$4.-TX
LAUNCH: U$1.22MA@ADC4 (CS4), U$15.5 (LAUNCH)
unnamed: R1.2, U$1.0V@ADC2 (0V)
unnamed: R4.2, U$2.0V@ADC2 (0V)
unnamed: PV1.1 (+PV), U$1.BAT (ALT)
unnamed: U$1.PWR, U$10.1 (+BAT)
unnamed: U$1.22MA@DIO2 (CS_DIVERSION), U$21.1 (DIVERSION)
unnamed: U$1.17MA@ICP1 (17MA), U$11.2 (PWR)
unnamed: U$1.ICP1, U$11.1 (PL)
unnamed: U$1.17MA@ICP3 (17MA), U$15.2 (START)
unnamed: U$1.ICP3, U$15.3 (STAR_RTN)
unnamed: U$1.22MA@DIO9 (CS_FAST), U$21.5 (FAST_FLOW)
unnamed: U$1.K3 (TX1), U$21.4 (RX)
unnamed: U$3.7 (BCM6), U$4.SHDN
unnamed: U$4.5V (PWR), U$19.SHLD_5V
unnamed: U$4.BM-TX (BM_TX), U$19.TX
unnamed: U$3.8 (I2C), U$4.SMBUS
unnamed: U$8.4 (-IN), U$19.ADC0 (ADC0_14)
unnamed: U$1.K1 (RX1), U$21.3 (TX)
unnamed: U$2.PWR, U$9.1 (+BAT)
unnamed: PV2.1 (+PV), U$2.BAT (ALT)
unnamed: U$1.17MA@ICP4 (17MA), U$15.1 (STOP)
unnamed: U$4.BM-RX (BM_RX), U$19.RX
unnamed: U$3.1 (CTS), U$4.!CTS
unnamed: U$3.2 (RTS), U$4.!RTS
unnamed: U$1.ICP4, U$15.4 (STOP_RTN)
unnamed: BL2.A, U$19.+CH6
unnamed: U$3.3 (RX), U$4.HOST-RX (HOST_RX)
unnamed: U$3.4 (TX), U$4.HOST-TX (HOST_TX)
unnamed: SD2.1, U$3.9 (SD)
unnamed: U$1.0V@DIO9 (0V), U$21.2 (GND)
unnamed: U$2.22MA@DIO2 (CS_DIVERSION), U$22.1 (DIVERSION)
unnamed: U$1.22MA@ADC1 (CS0), U$13.1 (4TO20)
unnamed: U$4.I2C0, U$19.I2C
unnamed: U$2.22MA@DIO9 (CS_FAST), U$22.5 (FAST_FLOW)
unnamed: R3.1, U$1.ADC1 (ADC0), U$13.2 (PWR)
unnamed: R2.2, U$1.ADC0 (ADC1), U$14.1 (4TO20)
unnamed: U$1.22MA@ADC0 (CS1), U$14.2 (PWR)
unnamed: R1.1, U$1.ADC2, U$12.1 (4TO20)
unnamed: PV1.2 (-PV), U$1.0V@PWR (0V), U$10.2 (-BAT)
unnamed: PV2.2 (-PV), U$2.0V@PWR (0V), U$9.2 (-BAT)
unnamed: RD2.A, U$19.+CH4
unnamed: U$3.12 (PWR), U$19.SHLD_VOUT (SHLD_VIN)
unnamed: PV4.2 (-PV), U$7.2 (-BAT), U$19.0V@PWR (0V)
unnamed: U$4.BM_!RST! (BM-!RST!), U$19.!RESET
unnamed: U$2.K3 (TX1), U$22.4 (RX)
unnamed: U$2.K1 (RX1), U$22.3 (TX)
unnamed: RD2.K, U$19.-CH4
unnamed: GN2.A, U$19.+CH5
unnamed: U$2.0V@DIO9 (0V), U$22.2 (GND)
unnamed: GN2.K, U$19.-CH5
unnamed: U$1.22MA@ADC2 (CS2), U$12.2 (PWR)
unnamed: BL2.K, U$19.-CH6
unnamed: R2.1, R3.2, U$1.0V@ADC1 (0V)
unnamed: U$2.17MA@ICP1 (17MA), U$16.2 (PWR)
unnamed: U$2.ICP1, U$16.1 (PL)
unnamed: R4.1, U$2.ADC2, U$17.1 (4TO20)
unnamed: U$2.22MA@ADC2 (CS2), U$17.2 (PWR)
unnamed: R5.2, U$2.ADC0 (ADC1), U$18.1 (4TO20)
unnamed: U$2.22MA@ADC0 (CS1), U$18.2 (PWR)
unnamed: R5.1, U$2.0V@ADC1 (0V)
unnamed: RD1.K, U$19.-CH1
unnamed: PV4.1 (+PV), U$8.1 (+DC), U$19.ADC2 (ADC2_16)
unnamed: U$7.1 (+BAT), U$8.2 (+IN), U$8.3 (-DC), U$19.PWR
unnamed: RD1.A, U$19.+CH1
unnamed: GN1.A, U$19.+CH2
unnamed: GN1.K, U$19.-CH2
unnamed: BL1.A, U$19.+CH3
unnamed: BL1.K, U$19.-CH3
READY: U$1.K2 (RX2), U$15.6 (READY)

Notes on the sheet:
CAT5
DTR PAIR
RX PAIR
TX PAIR
