epccs/Gravimetric/Applications/DayNight/Setup/LightSensorWiring.sch

## EAGLE design Applications/DayNight/Setup/LightSensorWiring.sch (2019-08-13)

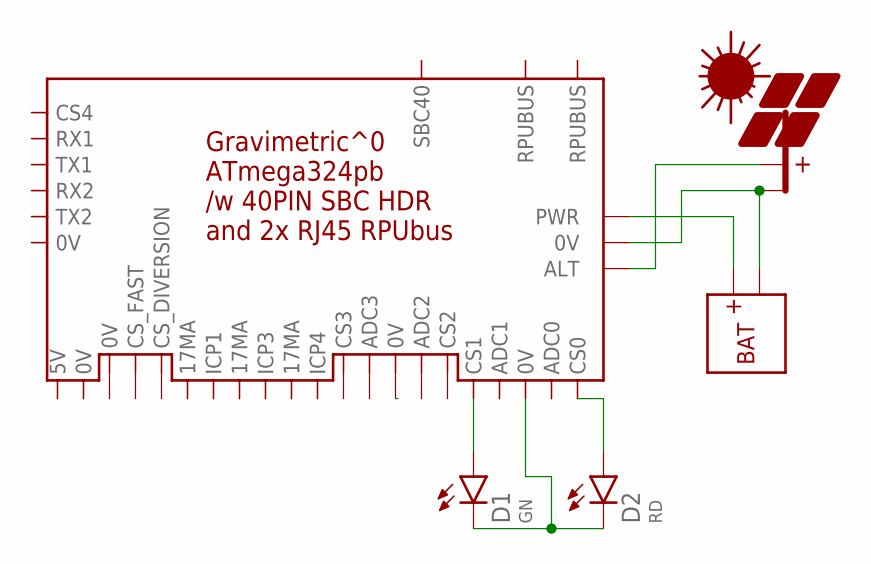
[picture p40: schematic LightSensorWiring.sch]

Parts:
D1: GN; LED5MM
D2: RD; LED5MM
PV4: PV; NA-30
U$1: GRAVIMETRIC; WITH_RPU_NAMES
U$7: BAT; NA-30

Connections:
0V: PV4.2 (-PV), U$1.0V@PWR (0V), U$7.2 (-BAT)
GN-WHT: U$1.0V@ADC2 (0V)
unnamed: U$1.PWR, U$7.1 (+BAT)
unnamed: D1.A, U$1.22MA@ADC0 (CS1)
unnamed: D2.A, U$1.22MA@ADC1 (CS0)
unnamed: D1.K, D2.K, U$1.0V@ADC1 (0V)
unnamed: PV4.1 (+PV), U$1.BAT (ALT)
