epccs/Gravimetric/Manager/manager/daynight_state.h

#ifndef Daynight_State_H
#define Daynight_State_H

typedef enum DAYNIGHT_STATE_enum {
    DAYNIGHT_STATE_START, // Start day-night state machine
    DAYNIGHT_STATE_DAY, // day
    DAYNIGHT_STATE_EVENING_DEBOUNCE, // was day, maybe a dark cloud, or the PV panel got covered
    DAYNIGHT_STATE_NIGHTWORK, // task to at start of night, lights enabled, PV panel blocked so it does not drain battery
    DAYNIGHT_STATE_NIGHT, // night
    DAYNIGHT_STATE_MORNING_DEBOUNCE, // was night, maybe a flash light or...
    DAYNIGHT_STATE_DAYWORK, // task to at start of day, charge battery, water the garden
    DAYNIGHT_STATE_FAIL
} DAYNIGHT_STATE_t;

extern DAYNIGHT_STATE_t daynight_state; 
extern unsigned long daynight_timer; // time recorded at start of last daynight_state event
extern unsigned long daynight_timer_at_night; // time recorded at night work event
extern unsigned long daynight_timer_at_day; // time recorded at day work event
extern unsigned long accumulate_alt_mega_ti_at_night; // accumulated timed ALT_I readings (amp hour) recorded at night work event
extern unsigned long accumulate_pwr_mega_ti_at_night; // accumulated timed PWR_I readings (amp hour) recorded at night work event
extern unsigned long accumulate_alt_mega_ti_at_day; // accumulated timed ALT_I readings (amp hour) recorded at day work event
extern unsigned long accumulate_pwr_mega_ti_at_day; // accumulated timed PWR_I readings (amp hour) recorded at day work event
extern uint8_t daynight_callback_address; // set callback address for daynight state machine, zero will stop sending events to application
extern uint8_t daynight_callback_route; // command number to use with daynight event updates.
extern uint8_t daynight_callback_poke; // don't poke me... oh you reset or I am hung in the fail mode.
extern uint8_t day_work_callback_route; // command number to use when day event occures, e.g., turn off lights, water garden, power SBC...
extern uint8_t night_work_callback_route; // command number to use when night event occures, e.g., your app can turn on lights and power off the SBC.

extern void check_daynight(void);

#endif // Daynight_State_H 
