epccs/Gravimetric/Applications/SpiSlv/main.c

/*
SPIslv is demonstration of an Interrupt-Driven SPI slave. 
Copyright (C) 2020 Ronald Sutherland

Permission to use, copy, modify, and/or distribute this software for any purpose with or without fee is hereby granted.

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
Note the library files are LGPL, e.g., you need to publish changes of them but can derive from this 
source and copyright or distribute as you see fit (it is Zero Clause BSD).

https://en.wikipedia.org/wiki/BSD_licenses#0-clause_license_(%22Zero_Clause_BSD%22)
*/

#include <stdbool.h>
#include <avr/pgmspace.h>
#include <util/atomic.h>
#include <util/delay.h>
#include "../lib/timers_bsd.h"
#include "../lib/uart0_bsd.h"
#include "../lib/parse.h"
#include "../lib/twi0_bsd.h"
#include "../lib/twi1_bsd.h"
#include "../lib/rpu_mgr.h"
#include "../lib/io_enum_bsd.h"
#include "../Uart/id.h"
#include "../i2c0-debug/i2c0-scan.h"
#include "../i2c0-debug/i2c0-cmd.h"
#include "../i2c0-debug/i2c0-monitor.h"
#include "../i2c1-debug/i2c1-scan.h"
#include "../i2c1-debug/i2c1-cmd.h"
#include "../i2c1-debug/i2c1-monitor.h"
#include "spi-cmd.h"

#define BLINK_DELAY 1000UL
static unsigned long blink_started_at;
static unsigned long blink_delay;
static char rpu_addr;

void ProcessCmd()
{ 
    if ( (strcmp_P( command, PSTR("/id?")) == 0) && ( (arg_count == 0) || (arg_count == 1)) )
    {
        Id("SpiSlv");
    }
    if ( (strcmp_P( command, PSTR("/spi")) == 0) && ( (arg_count == 1 ) ) )
    {
        EnableSpi(); // ./spi-cmd.c
    }
        if ( (strcmp_P( command, PSTR("/iscan?")) == 0) && (arg_count == 0) )
    {
        I2c0_scan();
    }
    if ( (strcmp_P( command, PSTR("/iaddr")) == 0) && (arg_count == 1) )
    {
        I2c0_address();
    }
    if ( (strcmp_P( command, PSTR("/ibuff")) == 0) )
    {
        I2c0_txBuffer();
    }
    if ( (strcmp_P( command, PSTR("/ibuff?")) == 0) && (arg_count == 0) )
    {
        I2c0_txBuffer();
    }
    if ( (strcmp_P( command, PSTR("/iwrite")) == 0) && (arg_count == 0) )
    {
        I2c0_write();
    }
    if ( (strcmp_P( command, PSTR("/iread?")) == 0) && (arg_count == 1) )
    {
        I2c0_read();
    }
    if ( (strcmp_P( command, PSTR("/imon?")) == 0) && (arg_count == 1) )
    {
        I2c0_monitor();
    }
    if ( (strcmp_P( command, PSTR("/i1scan?")) == 0) && (arg_count == 0) )
    {
        I2c1_scan();
    }
    if ( (strcmp_P( command, PSTR("/i1addr")) == 0) && (arg_count == 1) )
    {
        I2c1_address();
    }
    if ( (strcmp_P( command, PSTR("/i1buff")) == 0) )
    {
        I2c1_txBuffer();
    }
    if ( (strcmp_P( command, PSTR("/i1buff?")) == 0) && (arg_count == 0) )
    {
        I2c1_txBuffer();
    }
    if ( (strcmp_P( command, PSTR("/i1write")) == 0) && (arg_count == 0) )
    {
        I2c1_write();
    }
    if ( (strcmp_P( command, PSTR("/i1read?")) == 0) && (arg_count == 1) )
    {
        I2c1_read();
    }
    if ( (strcmp_P( command, PSTR("/i1mon?")) == 0) && (arg_count == 1) )
    {
        I2c1_monitor();
    }
}

void setup(void) 
{
    // Status LED
    ioDir(MCU_IO_CS0_EN, DIRECTION_OUTPUT);
    ioWrite(MCU_IO_CS0_EN, LOGIC_LEVEL_HIGH);
    
    //Timer0 Fast PWM mode, Timer1 & Timer2 Phase Correct PWM mode.
    initTimers(); 

    /* Initialize UART to 38.4kbps, it returns a pointer to FILE so redirect of stdin and stdout works*/
    stderr = stdout = stdin = uart0_init(38400UL, UART0_RX_REPLACE_CR_WITH_NL);

    // manager delays (blocks) for 50mSec after power up so i2c is not running yet
    _delay_ms(60); 

    /* Initialize I2C */
    twi0_init(100000UL, TWI0_PINS_PULLUP); 
    twi1_init(100000UL, TWI1_PINS_PULLUP);

    /* Initialize SPI*/
    spi_init();

    /* Clear and setup the command buffer, (probably not needed at this point) */
    initCommandBuffer();

    // Enable global interrupts to start TIMER0 and UART
    sei(); 
    
    blink_started_at = milliseconds();
    
    rpu_addr = i2c_get_Rpu_address();
    blink_delay = BLINK_DELAY;
    
    // blink fast if a default address from RPU manager not found
    if (rpu_addr == 0)
    {
        rpu_addr = '0';
        blink_delay = BLINK_DELAY/4;
    }
}

// Status LED
void blink(void)
{
    unsigned long kRuntime = elapsed(&blink_started_at);
    if ( kRuntime > blink_delay)
    {
        ioToggle(MCU_IO_CS0_EN);
        
        // next toggle 
        blink_started_at += blink_delay;
    }
}

int main(void) {    

    setup(); 

    while(1) 
    {
        // use LED to show if I2C has a bus manager
        blink();
        
        // check if character is available to assemble a command, e.g. non-blocking
        if ( (!command_done) && uart0_available() ) // command_done is an extern from parse.h
        {
            // get a character from stdin and use it to assemble a command
            AssembleCommand(getchar());

            // address is a char e.g. the ascii value for '0' warning: a null will terminate the command string. 
            StartEchoWhenAddressed(rpu_addr);
        }
        
        // check if the character is available, and if so stop transmit and the command in process.
        // a multi-drop bus can have another device start transmitting after the second received byte so
        // there is little time to detect a possible collision
        if ( command_done && uart0_available() )
        {
            // dump the transmit buffer to limit a collision 
            uart0_empty();

            // turn off the slave monitors
            twi1_slaveAddress(0);
            twi0_slaveAddress(0);

            initCommandBuffer();
        }
        
        // finish echo of the command line befor starting a reply (or the next part of reply)
        if ( command_done && (uart0_availableForWrite()) )
        {
            if ( !echo_on  )
            { // this happons when the address did not match
                initCommandBuffer();
            }
            else
            {
                // command is a pointer to string and arg[] is an array of pointers to strings
                // use findCommand to make them point to the correct places in the command line
                // this can only be done once, since spaces and delimeters are replaced with null termination
                if (command_done == 1)  
                {
                    findCommand();
                    command_done = 10;
                }
                
                if ( (command_done >= 10) && (command_done < 250) )
                {
                     ProcessCmd();
                }
                else 
                {
                    initCommandBuffer();
                }
            }
         }
    }        
    return 0;
}
