epccs/Gravimetric/Applications/Adc/analog.c

/*
analog is a library that returns Analog Conversions for channels 
Copyright (C) 2019 Ronald Sutherland

Permission to use, copy, modify, and/or distribute this software for any purpose with or without fee is hereby granted.

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
Note the library files are LGPL, e.g., you need to publish changes of them but can derive from this 
source and copyright or distribute as you see fit (it is Zero Clause BSD).

https://en.wikipedia.org/wiki/BSD_licenses#0-clause_license_(%22Zero_Clause_BSD%22)
*/

#include <stdbool.h>
#include <avr/pgmspace.h>
#include <util/atomic.h>
#include <avr/eeprom.h> 
#include <stdio.h>
#include <stdlib.h>
#include <ctype.h>
#include "../lib/parse.h"
#include "../lib/adc_bsd.h"
#include "../lib/rpu_mgr.h"
#include "../lib/twi0_bsd.h"
#include "../lib/timers_bsd.h"
#include "../lib/uart0_bsd.h"
#include "analog.h"
#include "references.h"

static unsigned long serial_print_started_at;

static uint8_t adc_arg_index;

static uint8_t adc_ch_from_manager;
static int temp_adc;
static float temp_ref_extern_avcc;
static float temp_ch_calibration_value;

// use a state machine to restore where the twi transaction is at 
static TWI0_LOOP_STATE_t twi0_loop_state = TWI0_LOOP_STATE_DONE;

/* return adc values */
void Analog(unsigned long serial_print_delay_milsec)
{
    if ( (command_done == 10) )
    {
        // check that arguments are digit in the range 0..7
        for (adc_arg_index=0; adc_arg_index < arg_count; adc_arg_index++) 
        {
            if ( ( !( isdigit(arg[adc_arg_index][0]) ) ) || (atoi(arg[adc_arg_index]) < ADC_CH_ADC0) || (atoi(arg[adc_arg_index]) > (ADC_CHANNELS+ADC_CH_MGR_MAX_NOT_A_CH)) )
            {
                printf_P(PSTR("{\"err\":\"AdcChOutOfRng\"}\r\n"));
                initCommandBuffer();
                return;
            }
        }
        // load reference calibration or show an error if they are not in eeprom
        if ( ! LoadAnalogRefFromEEPROM() )
        {
            printf_P(PSTR("{\"err\":\"AdcRefNotInEeprom\"}\r\n"));
            initCommandBuffer();
            return;
        }

        // print in steps otherwise the serial buffer will fill and block the program from running
        serial_print_started_at = milliseconds();
        printf_P(PSTR("{"));
        adc_arg_index= 0;
        command_done = 11;
    }
    else if ( (command_done == 11) )
    { // use the channel as an index in the JSON reply
        uint8_t arg_indx_channel =atoi(arg[adc_arg_index]);
        adc_ch_from_manager = ADC_CH_MGR_MAX_NOT_A_CH;
        switch (arg_indx_channel)
        {
            case ADC_CH_ADC0:
            case ADC_CH_ADC1:
            case ADC_CH_ADC2:
            case ADC_CH_ADC3:
            case ADC_CH_ADC4:
            case ADC_CH_ADC5:
            case ADC_CH_ADC6:
            case ADC_CH_ADC7:
                printf_P(PSTR("\"ADC%s\":"),arg[adc_arg_index]);
                command_done = 12;
                break;

            case (ADC_CHANNELS + ADC_CH_MGR_ALT_I): //was ADC5 on ^0, now it is on the manager ADC at channel 0
                printf_P(PSTR("\"ALT_I\":"));
                adc_ch_from_manager = ADC_CH_MGR_ALT_I;
                break;
            case (ADC_CHANNELS + ADC_CH_MGR_ALT_V): //was ADC4 on ^0, now it is on the manager ADC at channel 1
                printf_P(PSTR("\"ALT_V\":"));
                adc_ch_from_manager = ADC_CH_MGR_ALT_V;
                break;
            case (ADC_CHANNELS + ADC_CH_MGR_PWR_I): //was ADC6 on ^0, now it is on the manager ADC at channel 6
                printf_P(PSTR("\"PWR_I\":"));
                adc_ch_from_manager = ADC_CH_MGR_PWR_I;
                break;
            case (ADC_CHANNELS + ADC_CH_MGR_PWR_V): //was ADC7 on ^0, now it is on the manager ADC at channel 7
                printf_P(PSTR("\"PWR_V\":"));
                adc_ch_from_manager = ADC_CH_MGR_PWR_V;
                break;

            default:
                break;
        }
        
        if (adc_ch_from_manager == ADC_CH_MGR_MAX_NOT_A_CH)
        {
            temp_adc = adcAtomic((ADC_CH_t) arg_indx_channel); // application controller has adc value
            command_done = 20; 
        }
        else
        {
            twi0_loop_state = TWI0_LOOP_STATE_INIT; // manager has adc value, set init twi state for next step
            command_done = 12;
        }
    }
    else if ( (command_done == 12) )
    {
        temp_adc = i2c_get_adc_from_manager(adc_ch_from_manager, &twi0_loop_state);
        if (twi0_loop_state == TWI0_LOOP_STATE_DONE)
        {
            if (mgr_twiErrorCode)
            {
                printf_P(PSTR("\"Err=%d_ch=%d\"}\r\n"), mgr_twiErrorCode, adc_ch_from_manager);
                initCommandBuffer();
                return;
            }
            twi0_loop_state = TWI0_LOOP_STATE_INIT; // manager also has referance, set init twi state for next step
            command_done = 13;
        }
    }
    else if ( (command_done == 13) )
    {
        uint8_t command = 38; // access analog referance
        uint8_t select = 0; // select extern_avcc
        float update_with = 0.0; // select needs to be 0x80 to to do a upload (and save)
        float temp_float = i2c_float_access_cmd(command, select, &update_with, &twi0_loop_state);
        if (twi0_loop_state == TWI0_LOOP_STATE_DONE)
        {
            if (mgr_twiErrorCode)
            {
                printf_P(PSTR("\"Err=%d_extern_avcc\"}\r\n"),mgr_twiErrorCode);
                initCommandBuffer();
                return;
            }
            temp_ref_extern_avcc = temp_float;
            twi0_loop_state = TWI0_LOOP_STATE_INIT; // manager also has a callibraion, set init twi state for next step
            command_done = 14;
        }
    }
    else if ( (command_done == 14) )
    {
        uint8_t command = 33; // access channel calibration value
        uint8_t select = adc_ch_from_manager; // select channel calibration value
        float update_with = 0.0; // select needs to be 0x80, 0x81, 0x82... to to do an upload (and save)
        float temp_float = i2c_float_access_cmd(command, select, &update_with, &twi0_loop_state);
        if (twi0_loop_state == TWI0_LOOP_STATE_DONE)
        {
            if (mgr_twiErrorCode)
            {
                printf_P(PSTR("\"Err=%d_ch_cal\"}\r\n"),mgr_twiErrorCode);
                initCommandBuffer();
                return;
            }
            temp_ch_calibration_value = temp_float;
            command_done = 20;
        }
    }
    else if ( (command_done == 20) )
    {
        uint8_t arg_indx_channel = atoi(arg[adc_arg_index]);

        // There are values from 0 to 1023 for 1024 slots where each reperesents 1/1024 of the reference. Last slot has issues
        // https://forum.arduino.cc/index.php?topic=303189.0 
        // The BSS138 level shift will block voltages over 4.5V
        switch (arg_indx_channel)
        {
            case ADC_CH_ADC0:
            case ADC_CH_ADC1:
            case ADC_CH_ADC2:
            case ADC_CH_ADC3:
            case ADC_CH_ADC4:
            case ADC_CH_ADC5:
            case ADC_CH_ADC6:
            case ADC_CH_ADC7:
                printf_P(PSTR("\"%1.2f\""),(temp_adc*(ref_extern_avcc_uV/1.0E6)/1024.0));
                break;

            case (ADC_CHANNELS + ADC_CH_MGR_ALT_I): //was ADC5 on ^0, now it is on the manager ADC at channel 0
                // printf_P(PSTR("\"%1.3f\""),(temp_adc*((ref_extern_avcc_uV/1.0E6)/1024.0)/(0.018*50.0)));
                printf_P(PSTR("\"%1.2f\""), (temp_adc*temp_ref_extern_avcc*temp_ch_calibration_value) );
                break;
            case (ADC_CHANNELS + ADC_CH_MGR_ALT_V): //was ADC4 on ^0, now it is on the manager ADC at channel 1
                // printf_P(PSTR("\"%1.2f\""),(temp_adc*((5.0)*(110.0/10.0)/1024.0));
                printf_P(PSTR("\"%1.2f\""), (temp_adc*temp_ref_extern_avcc*temp_ch_calibration_value) );
                break;
            case (ADC_CHANNELS + ADC_CH_MGR_PWR_I): //was ADC6 on ^0, now it is on the manager ADC at channel 6
                // printf_P(PSTR("\"%1.3f\""),(temp_adc*((ref_extern_avcc_uV/1.0E6)/1024.0)/(0.068*50.0)));
                printf_P(PSTR("\"%1.2f\""), (temp_adc*temp_ref_extern_avcc*temp_ch_calibration_value) );
                break;
            case (ADC_CHANNELS + ADC_CH_MGR_PWR_V): //was ADC7 on ^0, now it is on the manager ADC at channel 7
                // printf_P(PSTR("\"%1.2f\""),(temp_adc*((ref_extern_avcc_uV/1.0E6)/1024.0)*(115.8/15.8)));
                printf_P(PSTR("\"%1.2f\""), (temp_adc*temp_ref_extern_avcc*temp_ch_calibration_value) );
                break;

            default:
                break;
        }

        if ( (adc_arg_index+1) >= arg_count) 
        {
            printf_P(PSTR("}\r\n"));
            command_done = 21;
        }
        else
        {
            printf_P(PSTR(","));
            adc_arg_index++;
            command_done = 11;
        }
    }
    else if ( (command_done == 21) ) 
    { // delay between JSON printing
        unsigned long kRuntime= elapsed(&serial_print_started_at);
        if ((kRuntime) > (serial_print_delay_milsec))
        {
            command_done = 10; /* This keeps looping output forever (until a Rx char anyway) */
        }
    }
    else
    {
        initCommandBuffer();
    }
}
