epccs/Gravimetric/Manager/manager/smbus_cmds.h

#ifndef SMBUS_cmds_H
#define SMBUS_cmds_H

#define SMBUS_BUFFER_LENGTH 32

extern uint8_t smbusBuffer[SMBUS_BUFFER_LENGTH];
extern uint8_t smbusBufferLength;
extern uint8_t smbus_oldBuffer[SMBUS_BUFFER_LENGTH]; //transmit oldBuffer
extern uint8_t smbus_oldBufferLength;
extern uint8_t transmit_data_ready;
extern uint8_t* inBytes_to_handle;
extern int smbus_has_numBytes_to_handle;

extern void receive_smbus_event(uint8_t*, uint8_t);
extern void transmit_smbus_event(void);
extern void handle_smbus_receive(void);

#endif // SMBUS_cmds_H 
