epccs/Gravimetric/(commit log)

2017-12-23 Hardware: Assembly and board images
2017-12-23 add the file back with the letter that changed case
2018-01-03 Hardware: bom
    [17341BRD,BOM.csv, 17341DIN,BOM.csv, 17341HDR,BOM.csv, 17341PLUG,BOM.csv, 17341SMD,BOM.csv]
2018-01-26 Hardware: ^0 review, add defaults, swap2 k1n, alt zener needs 100k
    [17341SMD,BOM.csv]
2018-02-08 Hardware: ^0 review, PWR_I sense, SHLD_VIN gate stress
    [17341SMD,BOM.csv, MultiDrop.sch]
2018-09-10 Hardware: ^0 reviewing
    [17341SMD,BOM.csv, MultiDrop.sch, SolarPwrOptions.sch]
2019-02-12 change board name to gravimetric, rewind status and setup for overhaul
    [17341BRD,BOM.csv, 17341DIN,BOM.csv, 17341HDR,BOM.csv, 17341PLUG,BOM.csv, 17341SMD,BOM.csv]
2019-02-15 Hardware: 324pb, only allow icp3 cs enable if spi slave select is high
2019-02-18 Hardware: schematic wip
2019-02-19 Hardware: schematic wip add rpupi
2019-02-22 Hardware: overview, 1mSec one-shot, nSS to nCE00
    [MultiDrop.sch]
2019-03-22 Hardware: ^0 relayout done, bom is next
2019-03-22 Hardware: documentation update for relayout
2019-03-24 Hardware: ^0 bom is done, next is review
    [17341BRD,BOM.csv, 17341CAT,BOM.csv, 17341DIN,BOM.csv, 17341HDR,BOM.csv, 17341PLUG,BOM.csv, 17341POL,BOM.csv, 17341SMD,BOM.csv, 17341TCOX,BOM.csv]
2019-05-26 Hardware: ^0 assembly
    [17341SMD,BOM.csv]
2019-05-27 Hardware: ^0 assembly done testing is next
    [17341SMD,BOM.csv]
2019-05-27 lib: atpack, avrdude, and some of Hernando's Wiring digital functions
2019-07-15 Manager: the board manager is from RPUpi/Remote fw
2019-07-18 App/Bootloader: optiboot builds, but not yet tested
    got schooling on power protection
2019-07-22 App/BlinkLED: first remote bootload with this board
2019-07-22 App/Uart: this adds twi0, twi1, parse, rpu_mgr, but dies not test twi1
2019-07-23 App/Adc: this adds adc, also input current and voltage look reasonable.
2019-07-24 App/i2c0-debut: twi0 goes to the master, twi1 goes to the I2C port on the board
2019-07-28 SelfTest: working but not finished
    [SelfTestWiring.sch]
2019-08-09 SelfTest: add i2c1 and smbus on R-Pi header
2019-08-13 App/DayNight: port from rpuno needed to evaluate alt power hack
    [LightSensorWiring.sch]
2019-08-15 Alternat: evaluation of modified ALT power input
2019-08-22 SelfTest: add one-shot test, add missing curr sour test, problem cs_diversion
    [main.c]
2019-08-22 Hardware: ^1 layout
    [17341SMD,BOM.csv]
2019-09-01 Hardware: reviewing
    [17341SMD,BOM.csv]
2019-09-12 SelfTest: ^0 self test changes to help cs_diversion stop for icp4
    [SelfTestWiring.sch]
2019-09-25 SelfTest: ^1 assembly done, note reflow disaster in schooling
    SelfTest: ^1 assembly done, note reflow disaster in schooling
    [17341SMD,BOM.csv]
2019-10-06 SelfTest: ICP4 one-shot time fixed, and evaluation with o-scope plots
    [main.c]
2019-10-14 Manager: for ^1 add some power management commands
2019-10-27 Manager: manage power, start with rudimentary alternate pwr control
2019-11-07 Manager: add battery limits for rudimentary alternate pwr control
2019-11-09 Manager: set battery limits with i2c
2019-11-10 Manager: battery absorption time (slow pwm of alt_en)
2019-11-13 Manager: day-night defaults (missing i2c functions, and the state machine)
    [battery_limits.c, daynight_limits.c, daynight_limits.h, main.c, smbus_cmds.c]
2019-11-16 Manager: day-night i2c functions (missing state machine)
    [i2c_cmds.c, i2c_cmds.h, smbus_cmds.c]
2019-11-19 SelfTest: ran with new manager fw, use lib function i2c_get_analogRead
2019-11-20 Adc: pin numbers, channels 4 to 7 are from manager over i2c
2019-11-23 manager i2c is not swaping its i2cBuffer with global values.
    [alternat.c, day_night.c, day_night.h, main.c]
2019-11-23 i2c command 0 changed to swap i2cBuffer and global, and it works.
    [battery_limits.c, daynight_limits.c, i2c_cmds.c, id_in_ee.c, main.c, references.c, smbus_cmds.c]
2019-11-24 i2c command 38 changed to swap 4 byte i2cBuffer and static, and works.
    [i2c_cmds.c, references.c, references.h]
2019-12-06 i2c command 21 22 23 52 53 54 are working now
2019-12-08 i2c command 18 19 20 are working now
2020-01-02 Manager: send channel and return analogRead with one i2c command
2020-01-29 Manager: send channel and return analogTimedAccumulation with one i2c command
2020-01-30 BlinkLED: license update and links LGPL uart0 lib
2020-01-31 BlinkLED: add some options to uart for replacing carriage return and newline
2020-02-03 Applications: BSD zero-clause linked with LGPL uart0 std IO facilities streams
2020-02-13 Manager: add channel calibration with a restricted license
    Manager/manager/main.c and Manager/manager/calibration_limits.c have all rights reserved, specifically, the right to distribute is withheld.
2020-02-16 Applications: uart0 disable, license setup changed
2020-02-18 Applications: i2c cmd 32 channel calibration returns 0x00000000
2020-02-18 Manager: add the i2c calibration function to the call tabel
2020-02-23 Apps: switch other applications to io_enum
2020-02-25 Manager: change referance to work like calibration
2020-02-26 Apps: timer with binary tick might help to extend input capture
2020-02-27 Apps: use binary tick timer on all applications
2020-02-27 Manager: use binary tick timer
2020-03-01 i2c0-debug: try an asynchronous i2c implementation
2020-03-08 i2c0-debug: asynchronous scan, e.g., non-blocking
2020-03-09 i2c0-debug: use asynchronous write with commands
2020-03-11 i2c0-debug: use asynchronous read with commands
2020-03-12 i2c0-debug: add slave monitor that echos sent data from master
2020-03-13 App: switch other applications to twi0_bsd
2020-03-13 i2c1-debug: add tool for second i2c port
2020-03-14 i2c1-debug: add read status that works like write status
2020-03-14 i2c1-debug: parse now allows /i4write and ilk, so include i2c0-debug commands
2020-03-20 SelfTest: second ^1 finaly got it to pass, but only after a power cycle
2020-03-24 Manager: check sneaky mode from R-Pi Zero UART
2020-03-24 Manager: blink status LED
2020-03-25 App/SpiSlv: evaluate SPI with R-Pi Zero
2020-03-31 App/Adc: enum 0..3 used for selecting channel, ADC_ENUM_ALT_I is not working
    [analog.c, calibration_limits.h, i2c_cmds.c]
2020-03-31 Manager: adc channel zero needs set up for the next burst
2020-04-01 Adc: readings from manager over non-blocking twi
2020-04-05 Adc: wip, got extern AVCC referance from manager over non-blocking twi
2020-04-07 Adc: manager channels now on 8..11 done with non-blocking twi
2020-04-10 Manager: wip to try i2c multi-master with daynight
2020-04-18 Manager: move arduino_mode i2c command, rename p2p as PVandBattery
2020-04-23 Manager: rename power mgr to battery mgr, state machine overhaul
2020-04-23 app/Battery: rename app
2020-04-27 App/Battery: wip, not yet working
2020-04-28 App/Battery: wip++, not yet working
2020-04-29 App/Battery: wip+++, overhaul bm, now somewhat working
2020-04-30 App/Battery: bm pwm mode with locked cycle at start of period
2020-04-30 App/Battery: add cli to change battery_low_limit and battery_high_limit
2020-05-01 App/DayNight: bug ul reading after seting a debounce returns 0 without error
    [analog.c, battery.c, day_night.c, day_night.h, main.c]
2020-05-10 Manager: status rm bits 4..6, at reset clear state machine callback for bm dn
    [battery_manager.c, battery_manager.h, daynight_state.h, dtr_transmition.c, i2c_cmds.c, rpubus_manager_state.c, rpubus_manager_state.h]
2020-05-17 Manager: host shutdown manager is wip, power the host down after test
    [17341HDR,BOM.csv]
2020-05-20 Manager: host shutdown wip, cmd 4 sets i2c callback for host shutdown
2020-06-11 App/Shutdown: wip sd_state not reporting during DOWN
    to take the host DOWN I can not use the callback address like I did with the battery manager.
2020-06-12 App/Shutdown: wip sd_state is stuck on CURR_CHK (sd_state = 3) when going DOWN
    [host_shutdown_manager.c, host_shutdown_manager.h, i2c_cmds.c, main.c, shutdown.c, shutdown.h]
2020-06-15 App/Battery: batmgr_state name change to bm_state
2020-06-17 Manager: bm is wip, this adds battery_host_limit to battery limits
2020-06-18 Manager: bm is wip, move i2c cmd
2020-06-19 Manager: bm is wip, but first update daynight uint16 i2c access
2020-06-19 Manager: bm is wip, but first update daynight uint32 i2c access
2020-06-20 App/DayNight: bm is wip, but this works with the changed i2c access cmds
2020-06-21 App/Battery: bm is wip, but need this to work with the changed i2c cmds
2020-06-27 Manager: bm accumulats pwm time, does pwm from low to high limit
2020-07-06 Manager: better bm pwm transition from 100% to 90%
2020-07-08 Manager: set up i2c callback poke for shutdown
2020-07-09 Manager: set up i2c callback poke for bm, sbc power cntl is in place
2020-07-11 Manager: set low battery bit in status
2020-07-12 Manager: set stauts low bit fixed, trying to get bm_enable set at power up
    [battery_manager.c, main.c, rpubus_manager_state.c]
2020-07-15 Manager: debuging... i2c bm poke, fixed so it does not change bm_enable
    [battery.c, battery.h, battery_manager.c, battery_manager.h, day_night.c, daynight_state.c, daynight_state.h, host_shutdown_manager.c]
2020-07-16 Manager: evaluating, adj hs limits, i2c mulit-master issue #3 seen
    [host_shutdown_limits.c, host_shutdown_limits.h]
2020-07-20 Hardware: ^2 review
    [17341BRD,BOM.csv, 17341CAT,BOM.csv, 17341DIN,BOM.csv, 17341HDR,BOM.csv, 17341PLUG,BOM.csv, 17341POL,BOM.csv, 17341SMD,BOM.csv, 17341TCOX,BOM.csv]
2020-07-30 App/Time-WeightCal: notes
    [17341SMD,BOM.csv]
2020-08-23 Hardware: smoked manager with a powered board in 2x20 header, + core updates
    [17341SMD,BOM.csv]
