epccs/Gravimetric/(notices)

Notices in the files:
Applications/Bootloader/main.c:
Public License as published by the Free Software
Applications/SpiSlv/spidev_test.c:
This program is free software; you can redistribute it and/or modify
it under the terms of the GNU General Public License as published by
the Free Software Foundation; either version 2 of the License.
parts and their libraries:
Documentation: Copyright (C) 2014 Ronald Steven Sutherland
Attribution Share-Alike 3.0 License
http://creativecommons.org/licenses/by-sa/3.0
D-LED: Copyright (C) 2013 Ronald Steven Sutherland
